arifainchtein/Daffodil/Pin Header 1x4 TH Pitch 2.54mm.stp

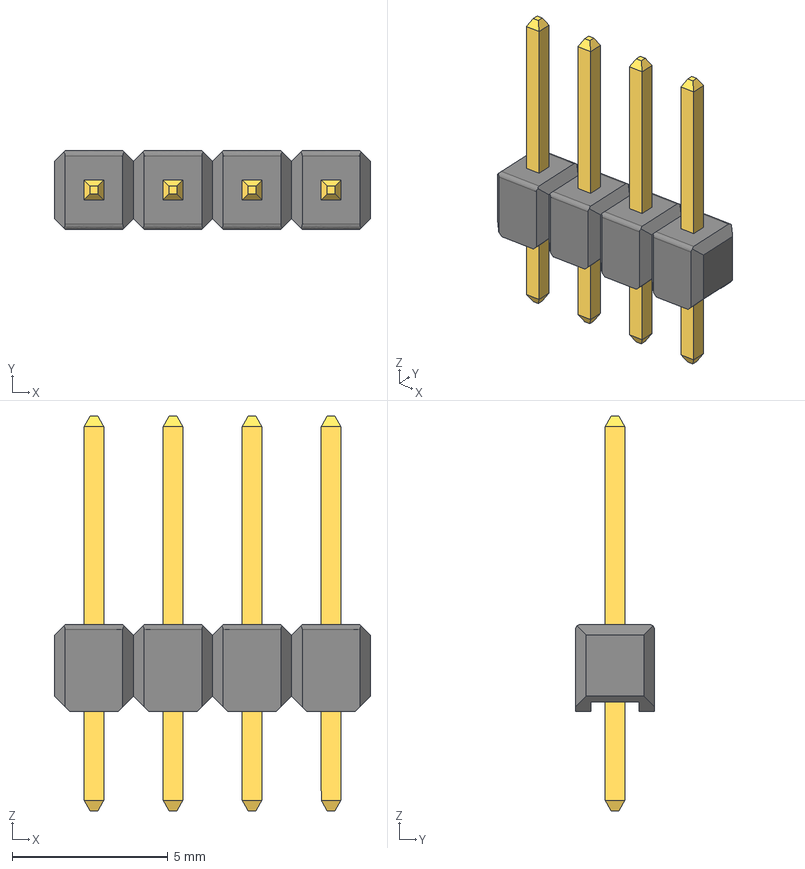
[picture p2: CAD file, 2025-03-26, last stored version]
Pin Header 1x4 TH Pitch 2.54mm.stp
10.2 x 2.54 x 12.7 mm
