arifainchtein/Daffodil/Clipsal 4 Way 20mm enclosure v2.dxf

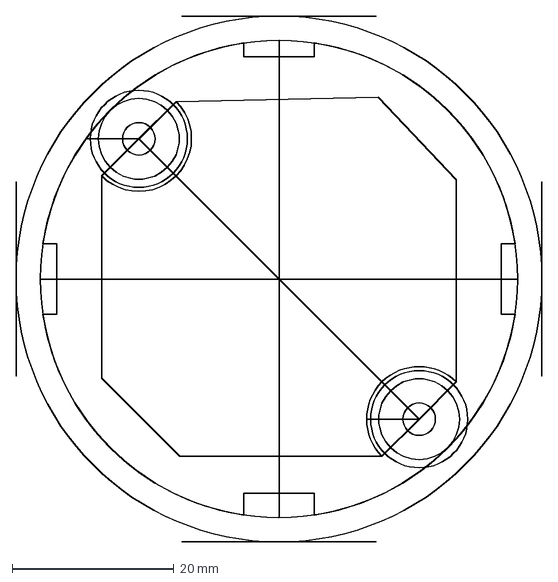
[picture p3: CAD file, 2025-03-26, last stored version]
Clipsal 4 Way 20mm enclosure v2.dxf
65.0 x 65.0 mm
