arifainchtein/Daffodil/PCB For Clipsal 4 Way 20mm enclosure v2.stl

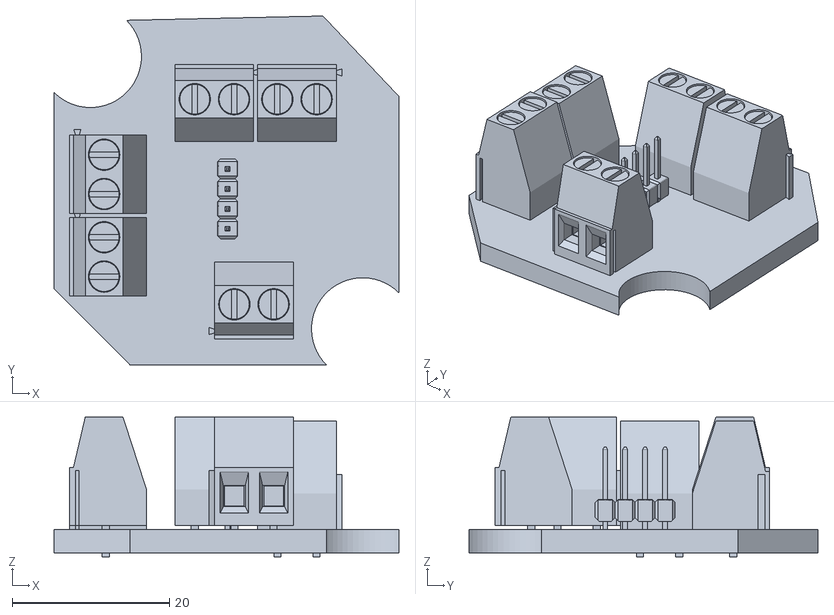
[picture p4: CAD file, 2025-03-26, last stored version]
PCB For Clipsal 4 Way 20mm enclosure v2.stl
43.8 x 44.4 x 17.8
