arifainchtein/Daffodil/PCB Clipsall 4 way.dxf

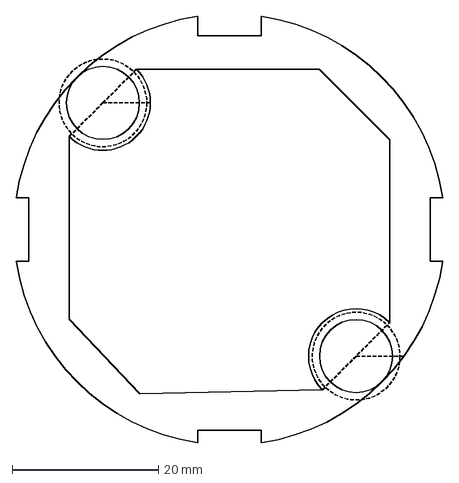
[picture p5: CAD file, 2025-03-26, last stored version]
PCB Clipsall 4 way.dxf
58.4 x 58.4 mm
