arifainchtein/Daffodil/pcb.dxf

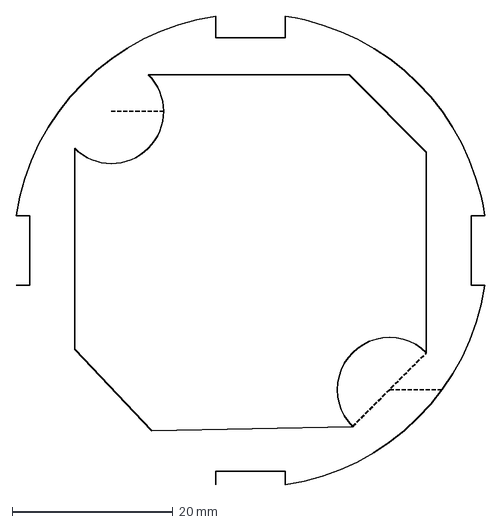
[picture p6: CAD file, 2025-03-26, last stored version]
pcb.dxf
58.4 x 58.4 mm
