arifainchtein/Daffodil/(list of files, cad)

Other CAD files:
Clipsal 4 Way 20mm enclosure v2.f3z
