arifainchtein/Daffodil/Daffodil.ino

/// New Version
#include <PowerManager.h>
#include <DeviceSerial.h>  // the serial number is the efuse MAC (2026-10-30)
#include <SolarInfo.h>
//#include <TimeUtils.h>
#include "Arduino.h"
#include <Timer.h>
#include <PCF8563TimeManager.h>
#include <SPI.h>
#include <LoRa.h>
#include <NewPing.h>  // DAFFODIL_SONAR_TROUGH - echo/trigger ultrasonic on the older boards (2026-11-10)
#include <Esp32SecretManager.h>
#include <FastLED.h>
#include <DaffodilWifiManager.h>
//#include <DaffodilData.h>
#include "OneWire.h"
#include "DallasTemperature.h"
#include <Wire.h>
#include <sha1.h>
#include <totp.h>
#include <SolarPowerData.h>
#include <DigitalStablesData.h>
#include <ChinampaData.h>
#include <LangleyData.h>  // Viewer shows Langley packets
#include "ViewerConfig.h"  // Viewer function (switch 1001)
#include <WeatherForecastManager.h>
#include <DigitalStablesDataSerializer.h>
#include "ADS1X15.h"
#include "SHTSensor.h"

#include <ErrorManager.h>
#include <ErrorDefinitions.h>
#include <DataManager.h>
#include "CommaRecord.h"
#include <LittleFS.h>
#include <Preferences.h>
//#include <driver/adc.h>
#include <BH1750.h>
#include <Adafruit_INA219.h>
#include <VitalSignsTracker.h>
#include <DeviceIdentityTracker.h>
#include <PowerProfileRecord.h>
#include <DeviceCommandRecord.h>
#include <LinkAckRecord.h>
#include <esp_sleep.h>
//#include <driver/adc.h>

#define RTC_CLK_OUT 4
#define MISO 12
#define MOSI 13
#define SCK 14
#define LoRa_SS 15
#define LORA_RESET 16
#define LORA_DI0 17
#define LED_PIN 19
#define LED_CONTROL 23
#define TPL5010_DONE 25
#define SLEEP_SWITCH_26 26
#define TEMPERATURE 27
#define OP_MODE 34
#define SENSOR_INPUT_2 33
#define SENSOR_INPUT_1 18
//#define ADS115_ALERT 35
#define TPL5010_WAKE 35
#define RTC_BATT_VOLT 36



Adafruit_INA219 ina219(0x41);
Adafruit_INA219 solarIna219(0x45);  // Wally USB/panel current sensor — same 50mΩ shunt (LVK12R050CER) as ina219(0x41)
float SHUNT_OHMS = 0.050;    // Shunt resistor value in Ohms — JLCPCB C2596036 50mΩ
#define MAX_CURRENT 1.0      // Maximum expected current in Amps
#define CURRENT_LSB 0.0001   // Current LSB in A/bit — Adafruit default (100µA/bit for 32V/2A mode)
boolean memoryFull = false;
static volatile bool runWatchdog = true;

// Survive deep sleep only. A TPL5010 reset (via EN) or brownout is a power-on reset and clears
// them - which is why the TPL5010 WAKE pulse is a deep-sleep wake source (armDeepSleepWakeSources()).
RTC_DATA_ATTR static uint32_t rtc_intended_wakeup_time = 0; // intended wakeup Unix-seconds
RTC_DATA_ATTR static bool     rtc_comma_mode = false;       // battery critically low; skip full boot
RTC_DATA_ATTR static bool     rtc_has_comma_data = false;   // COMMA session just ended, send recovery LoRa
RTC_DATA_ATTR static uint32_t rtc_comma_first_time = 0;     // Unix-seconds when this COMMA session started
RTC_DATA_ATTR static float    rtc_comma_min_voltage = 99.0f;// lowest voltage seen in this COMMA session
RTC_DATA_ATTR static uint32_t rtc_comma_cycle_count = 0;    // number of 10-min cycles in this session
RTC_DATA_ATTR static char     rtc_device_shortname[8] = {0};// device short name, populated on full boot

// Vital signs (reset / sleep / power / TX telemetry), sent after the data pulse - replaces the
// on-demand DiagnosticRecord (EnableDiagnostics/DisableDiagnostics), retired 2026-10-05.
// See VitalSignsTracker.h and Projects/Annabelle/VitalSigns_Design.pdf.
VitalSignsTracker vitalSigns;
const uint32_t FIRMWARE_BUILD = VitalSignsTracker::buildStamp(__DATE__, __TIME__);
#define VITAL_SIGNS_GAP_MS 1000                         // after the data packet, so Annabelle has read it
// Device identity (product definition + running build), sent after VitalSigns when due - after a
// real reset, after SetProductDefinition, and daily. See DeviceIdentityTracker.h.
DeviceIdentityTracker deviceIdentity;
#define VITAL_SIGNS_AWAKE_INTERVAL_MS (10UL * 60UL * 1000UL)  // only for a unit that stays awake
unsigned long lastVitalSignsMs = 0;
// Copy of the last VitalSignsRecord built, for the web page's Power panel (fillPowerData, 2026-10-14).
// Written in loop(), read by the async_tcp task - lastVitalSignsMux.
VitalSignsRecord lastVitalSigns;
bool haveLastVitalSigns = false;
unsigned long lastVitalSignsBuiltMs = 0;
portMUX_TYPE lastVitalSignsMux = portMUX_INITIALIZER_UNLOCKED;
// COMMA log relay (sendNextCommaRecord): position in the log, consecutive send failures, and a
// stop flag after too many failures this wake. Not RTC - a new wake starts again from record 0.
int commaSendIndex = 0;
uint8_t commaSendFailures = 0;
bool commaSendPaused = false;
#define COMMA_SEND_MAX_FAILURES 5
#define COMMA_SEND_INTERVAL_SEC 2   // seconds between CommaRecord packets, so Annabelle keeps up

String currentSSID;
String ipAddress = "";
boolean initiatedWifi = false;
// #define address 0x40
SHTSensor sht;
bool debug = false;
DataManager dataManager(Serial, LittleFS);

HourlySolarPowerData hourlySolarPowerData;
boolean usingSolarPower = true;

#define NUM_LEDS 15
CRGB leds[NUM_LEDS];

// Maximum trough/tank depth in cm — used to scale measuredHeight into a percentage for the LEDs.
#define MAX_DISTANCE 90

// Waterproof UART ultrasonic (A02YYUW / JSN-SR04T / AJ-SR04M "UART auto" mode). The sensor
// streams a 4-byte frame on its own (every 100-500ms with its RX pin floating/high = processed
// value, the mode we use; ~100ms real-time if RX is pulled low): 0xFF, distance_mm high, distance_mm low,
// checksum = (0xFF + high + low) & 0xFF, at 9600 8N1. RX only — the sensor's own RX pin is left
// unconnected (auto mode needs no trigger). Power it from V50 — the pin 18/33 terminals go
// through the board's 2N7002 level shifters (Q2/Q1), so a 5V TX line is safe.
//
// Pin use per mode (no DigitalStablesData change — slot 2 reuses measuredHeight2):
//   DAFFODIL_WATER_TROUGH        pin18 ultrasonic -> measuredHeight
//   DAFFODIL_WATER_TROUGH_WATER_TEMP pin18 ultrasonic -> measuredHeight, pin33 DS18B20 water temp -> measuredHeight2 (°C)
//   DAFFODIL_2_WATER_TROUGH      pin18 ultrasonic -> measuredHeight, pin33 ultrasonic         -> measuredHeight2 (cm)
//   DAFFODIL_SCEPTIC_TANK        pin18 ultrasonic -> measuredHeight
//   DAFFODIL_WATER_TROUGH_TANK1  pin18 is tank1 pressure, so pin33 ultrasonic -> measuredHeight
//   DAFFODIL_SONAR_TROUGH        echo/trigger ultrasonic, trigger 32 / echo 33 -> measuredHeight (see below)
#define ULTRASONIC_BAUD 9600
#define ULTRASONIC_STALE_MS 5000  // no valid frame for this long -> -99
struct UartUltrasonic {
  HardwareSerial *serial;
  bool started;
  uint8_t frame[4];
  uint8_t frameIndex;
  float lastCm;
  unsigned long lastMillis;
};
UartUltrasonic ultrasonic1 = { &Serial2, false, { 0 }, 0, -99, 0 };  // measuredHeight
UartUltrasonic ultrasonic2 = { &Serial1, false, { 0 }, 0, -99, 0 };  // measuredHeight2 (DAFFODIL_2_WATER_TROUGH)

// DAFFODIL_SONAR_TROUGH (2026-11-10, switch 0101): a trough read by an echo/trigger ultrasonic
// (HC-SR04 / JSN-SR04T in trigger mode) with trigger on 32 and echo on 33 - the wiring of the older
// boards that ran DaffodilBuild14 (Pancho Build 15), e.g. the Chinampa Fish Tank. Same NewPing reading
// that firmware did. Created only in this mode: NewPing's constructor drives its trigger pin, and
// 32/33 have other uses on newer boards. 0 cm = no echo (out of range or no sensor), as DaffodilBuild14
// sent it - Chinampa treats a measuredHeight of 0 as a sensor failure (alert 7) and stops the pump.
#define SONAR_TRIGGER_PIN 32
#define SONAR_ECHO_PIN 33
#define SONAR_MAX_DISTANCE_CM 200
#define SONAR_PINGS 5             // median of 5 (~150 ms)
NewPing *sonar = nullptr;

// TX-summary sampler. Must stay below the struct definitions: the IDE inserts its auto-prototypes
// just above the first function in the sketch, so defining one earlier hides UartUltrasonic from them.
// Called on core 0 while sendMessage() blocks in LoRa.endPacket(false).
// INA219 current is + while the battery discharges (batteryCurrent < 0 means charging).
bool daffodilTxSample(int16_t &batteryDraw_mA, uint16_t &battery_mV) {
  batteryDraw_mA = (int16_t)(ina219.getShuntVoltage_mV() / SHUNT_OHMS);  // getCurrent_mA() reads half on 50 mOhm
  battery_mV = (uint16_t)(ina219.getBusVoltage_V() * 1000.0f);
  return true;
}

// The battery ledger (VitalSignsTracker::startLedger) reads both INA219s from core 0 every ~70 ms
// while the main code on core 1 also reads them. An INA219 read is a register-pointer write then a
// read, so the two can get each other's register - every INA219 access holds this lock (recursive,
// so nested helpers are fine). Created first thing in setup().
// Since 2026-10-13 it guards EVERY I2C read on core 1, not just the INA219s: Wire has one receive
// buffer, so a ledger read between another device's requestFrom() and its Wire.read()s replaces
// those bytes (an RTC read gave 2030-2032 dates with the right time of day). The RTC is read once
// per clock tick (loop) under this lock; everything else uses currentTimerRecord.
SemaphoreHandle_t inaMutex = nullptr;
struct InaLock {
  InaLock() { if (inaMutex) xSemaphoreTakeRecursive(inaMutex, portMAX_DELAY); }
  ~InaLock() { if (inaMutex) xSemaphoreGiveRecursive(inaMutex); }
};

extern bool foundINA219;       // defined with the other sensor flags further down
extern bool foundINA219Solar;

// Ledger callback (core 0): battery and panel read back to back under the lock.
bool daffodilLedgerSample(LedgerSample &s) {
  if (!foundINA219) return false;
  InaLock lock;
  float batShunt_mV = ina219.getShuntVoltage_mV();
  float batBus_V = ina219.getBusVoltage_V();
  s.battery_uA = (int32_t)(batShunt_mV / SHUNT_OHMS * 1000.0f);
  s.battery_mV = batBus_V > 0 ? (uint16_t)(batBus_V * 1000.0f) : 0;
  if (foundINA219Solar) {
    float panShunt_mV = solarIna219.getShuntVoltage_mV();
    float panBus_V = solarIna219.getBusVoltage_V();
    s.panel_uA = (int32_t)(panShunt_mV / SHUNT_OHMS * 1000.0f);
    s.panel_mV = panBus_V > 0 ? (uint16_t)(panBus_V * 1000.0f) : 0;
  } else {
    s.panel_uA = 0;
    s.panel_mV = 0;
  }
  return true;
}

// Ledger mode callback: single-sample battery conversions during a LoRa TX (true peak), back to
// 128-sample averaging after. Only the shunt ADC bits (6:3) change.
void daffodilLedgerMode(bool fastMode) {
  InaLock lock;
  Wire.beginTransmission(0x41);
  Wire.write(0x00);
  if (Wire.endTransmission() != 0) return;
  if (Wire.requestFrom((uint8_t)0x41, (uint8_t)2) < 2) return;
  uint16_t cfg = ((uint16_t)Wire.read() << 8) | (uint8_t)Wire.read();
  cfg = (cfg & ~0x0078) | (fastMode ? INA219_CONFIG_SADCRES_12BIT_1S_532US : INA219_CONFIG_SADCRES_12BIT_128S_69MS);
  Wire.beginTransmission(0x41);
  Wire.write(0x00);
  Wire.write((cfg >> 8) & 0xFF);
  Wire.write(cfg & 0xFF);
  Wire.endTransmission();
}

// Waterproof DS18B20 water temperature on pin 33 (DAFFODIL_WATER_TROUGH_WATER_TEMP only), its own OneWire
// bus separate from the board DS18B20 on pin 27. No external pull-up needed: the pin-33 terminal
// already goes through the board's 2N7002 level shifter (Q1, R5 4.7k to V33 on the GPIO side,
// R7 10k to V50 on the terminal side), so the probe runs off V50 and the 10k is the bus pull-up.
OneWire waterOneWire(SENSOR_INPUT_2);
DallasTemperature waterTempSensor(&waterOneWire);
bool waterTempStarted = false;

#define OPERATING_STATUS_SLEEP 1
#define OPERATING_STATUS_NO_LED 2
#define OPERATING_STATUS_FULL_MODE 3
#define OPERATING_STATUS_CLOUDY 4
#define OPERATING_STATUS_COMMA 5   // battery critically low — permanent deep sleep


ErrorManager errorManager;



// LoRa parameters, registers and constants



#define REG_OP_MODE 0x01
#define REG_IRQ_FLAGS 0x12
#define REG_RSSI_VALUE 0x1B
#define MODE_CAD 0x87
#define IRQ_CAD_DONE_MASK 0x04
#define IRQ_CAD_DETECTED_MASK 0x02

#define CAD_TIMEOUT 5000    // CAD timeout in milliseconds
#define MAX_RETRIES 5       // Maximum transmission retries
#define MIN_BACKOFF 500     // Minimum backoff time in milliseconds
#define MAX_BACKOFF 1500    // Maximum backoff time in milliseconds
#define RSSI_THRESHOLD -80  // RSSI threshold in dBm





//define LORA_SAMPLES 3 // Number of samples to take
//define CHECK_LORA_DELAY 2 // Delay between samples in ms

//CHT8305 CHT(0x44);
bool loraTxOk = false;


//TaskHandle_t watchdogTask;
//i2c addresses:
// 40=DFRobot i2c temperature sensor
// 48= ADS1115
// 51= PCF8563T
// 23= bh1750

BH1750 lightMeter;

ADS1115 ADS(0x48);
volatile bool RDY = false;

OneWire oneWire(TEMPERATURE);
DallasTemperature tempSensor(&oneWire);

Timer viewTimer(3);
Timer remoteMonitorTimer(5);
#define MAXIMUM_STORED_RECORDS 2000

// bool internetAvailable;
bool wifiActiveSwitch;
#define uS_TO_S_FACTOR 60000000 /* Conversion factor for micro seconds to minutes */

Timer dsUploadTimer(60);
static volatile int flowMeterPulseCount;
static volatile int flowMeterPulseCount2;
static unsigned long flowMeterPreviousMillis = 0;
static unsigned long flowMeterPreviousMillis2 = 0;

volatile bool loraReceived = false;
volatile int loraPacketSize = 0;
volatile bool loraDio0Fired = false;  // set by onLoraDio0(), handled at the top of loop()


uint8_t displayStatus = 0;
uint8_t loraLastResult = -99;
LoRaError cadResult;
float avgRssi = 0;

#define SHOW_TEMPERATURE 0
#define SHOW_SCEPTIC 1
#define SHOW_INTERNET_STATUS 2
#define SEND_LORA_STATUS 3
#define SHOW_ERROR_STATUS 5
#define SHOW_BATTERY_STATUS 4
//
// sleeping parameters
//
// LiFePO4 battery thresholds (Build 7: replaced supercapacitors with 3.2V LiFePO4 cell)
#define BATTERY_CAPACITY_MAH 600.0   // usable capacity of LiFePO4 123A cell
// PowerProfileRecord - this product's battery/sensor hardware facts for the Cerebellum's SOC
// (a battery or panel change means editing these and reflashing). 0 = "use the default".
#define PP_CHEMISTRY            BATTERY_CHEMISTRY_LIFEPO4
#define PP_CELLS_IN_SERIES      1
#define PP_CAPACITY_MAH         600
#define PP_CHARGE_EFFICIENCY    0         // Cerebellum default for LiFePO4
#define PP_REST_FULL_MV         0
#define PP_REST_EMPTY_MV        0
#define PP_ABSORPTION_MV        3600      // MCP73123-22 regulation voltage
#define PP_CUTOFF_MV            2800      // = commaVoltage
#define PP_BATTERY_TEMP_SOURCE  BATTERY_TEMP_SOURCE_NONE
#define PP_BATTERY_LSB_UA       200       // 50 mOhm shunt, 10 uV INA219 shunt LSB
#define PP_PANEL_LSB_UA         200
#define PP_SLEEP_UA             0         // not bench-measured yet
#define PP_UNMEASURED_BASELINE_UA 0
#define NIGHT_MAX_SLEEP_SEC 300      // longest sleep while the cell is healthy: a packet every 5 min all night (timer wakes before the ~10 min TPL5010 pulse)
#define NIGHT_CAP_MIN_VOLTAGE 3.15   // battery (under wake load) at or above this gets the 15 min cap

// WiFi on demand (2026-10-14). The automatic start needs the battery above 3.35 V for 30 s, which
// a Daffodil only reaches while charging hard around midday - so its web page (settings, vital
// signs) was out of reach most of the day. A DeviceCommandRecord from Annabelle's web page or
// Paula turns WiFi on for a while regardless (and keeps the unit awake for it), or off. See
// acceptDeviceCommand() and listenForReplies().
#define WIFI_ON_DEMAND_DEFAULT_MIN 15
#define WIFI_ON_DEMAND_MAX_MIN 60
#define WIFI_ON_DEMAND_FLOOR_V 3.20f    // below this (under load) on-demand WiFi ends and the unit may sleep
#define WIFI_OFF_SUPPRESS_AUTO_SEC 3600 // after an explicit "off", the automatic midday start waits this long
#define COMMAND_LISTEN_MS 700           // listen after each VitalSigns: sender's 100 ms + CAD + ~0.19 s on air + margin
// 1 = listen after every VitalSigns, day and night (~1.5-2 mAh a night at 5 min wakes, whether
// or not a command ever comes). 0 = daylight only: no night cost, a night command waits for sunrise.
#define LISTEN_FOR_COMMANDS_AT_NIGHT 1
#define DEVICE_COMMAND_MAX_CLOCK_DIFF_SEC 900
RTC_DATA_ATTR uint32_t wifiOnDemandUntil = 0;        // code-time seconds (getTimeForCodeGeneration), 0 = off
RTC_DATA_ATTR uint32_t wifiAutoSuppressedUntil = 0;  // code-time seconds, see WIFI_OFF_SUPPRESS_AUTO_SEC
bool wifiOnDemandWasOn = false;  // loop(): on-demand WiFi was running last pass - notices its end
bool wifiOffRequested = false;   // set by acceptDeviceCommand(), acted on in loop()
float sleepingVoltage = 3.12;         // Force deep sleep — cliff edge for LiFePO4 123A
float commaVoltage    = 2.80;         // COMMA threshold — below this, skip all work and wait for solar recovery
float commaExitVoltage = 3.12;        // COMMA only ends once the resting battery reaches this (= sleepingVoltage).
                                      // Exiting at commaVoltage itself looped forever on a weak cell: it rests
                                      // just above 2.80V, boots, WiFi load sags it below, COMMA again (2026-11-06).
                                      // A charging LiFePO4 sits well above this, so charging also ends COMMA.

uint8_t numberSecondsWithMinimumWifiVoltageForStartWifi = 30;
uint8_t currentSecondsWithWifiVoltage = 0;
float minimumInitWifiVoltage = 3.35;  // Battery must sustain this for 30 s before WiFi starts
//uint8_t sleepingTime = 1;
float minimumLEDVoltage = 3.18;       // Turn off LEDs below this — warning before sleep at 3.15V
float minimumVoltageForSleepLedAlert = 3.10;  // goToSleep() only flashes the 1 s battery indicator at or above this. Below it the ~150 mA LED load browned the board out on a low cell (TopTank 2026-10-07: ~46 brownout resets from 2.80 V to 1.2 V) — the sleep LoRa message is still sent.
uint8_t dimLedBrightness = 20;        // Minimum brightness when LoRa TX budget is too low for full power
uint8_t nightLedBrightness = 30;      // Minimum LED brightness (night / zero efficiency)
float luxNightThreshold = 30.0;       // Lux below this is considered actual darkness → cap at nightLedBrightness
float currentLux = -99;               // Local only, not transmitted — removed from DigitalStablesData 2026-09-01 to fund measuredHeight2/maximumScepticHeight2. Still read locally from BH1750 for LED darkness detection, same as always.
float ledCurrentPerLedAmps = 0.020;   // Same per-LED current budget PowerManager uses (currentPerLed in setup()) — kept as its own constant here so calculatePowerAwareLedBrightness() doesn't need setup()'s local copy.
float v50iCloudyThreshold = 3.5;     // V50_I below this during solar hours means the panel isn't harvesting enough — cloudy. Lowered 2026-07-24: field data (TopTank, clear midday sun, actively charging) showed V50_I sitting at 4.09-4.47V — the old 4.5V threshold was false-triggering CLOUDY on every wake. Still wants validation against real overcast-day readings.
float panelCurrentCloudyThreshold_mA = 30.0;  // Doubled 2026-10-10 when panelCurrent switched from getCurrent_mA() (half scale on the 50mOhm shunt) to shunt mV / SHUNT_OHMS - same real threshold as the old 15. Wally 0x45 panelCurrent below this during solar hours means cloudy. Lowered 2026-07-24: field data (TopTank, clear midday sun) showed panelCurrent as low as 22-80mA during normal charging — the old 60mA threshold was false-triggering CLOUDY. Still wants validation against real overcast-day readings.
float minimumWifiVoltage = 3.28;      // Turn off WiFi first to preserve power for LoRa
// Solar switch OFF (2026-11-06): a charged LiFePO4 rests at ~3.30V and sags under the AP's load, so
// 3.35 start / 3.28 cut-off meant WiFi rarely started and dropped the moment a phone connected
// (HorseTrough). Same 0.1V start/stop gap, set below the cell's working plateau, above sleepingVoltage.
float minimumInitWifiVoltageNoSolar = 3.25;
float minimumWifiVoltageNoSolar = 3.15;
float wifiStartVoltage() { return usingSolarPower ? minimumInitWifiVoltage : minimumInitWifiVoltageNoSolar; }
float wifiCutVoltage() { return usingSolarPower ? minimumWifiVoltage : minimumWifiVoltageNoSolar; }
uint8_t secondsSinceLastDataSampling = 0;
uint16_t secondsSinceLastWeatherData = 9999; // 9999 = never received
// RTC time the last forecast was accepted, so "weather fresh" (opMode bit1, LED 14, the cloudy
// forecast check) survives deep sleep: secondsSinceLastWeatherData is plain RAM and restarted at
// 9999 on every wake, so a sleeping unit reported "not fresh" right after accepting a forecast
// (TopTank 2026-10-12). Lost on a real reset like every RTC_DATA_ATTR - then "never" is correct.
RTC_DATA_ATTR uint32_t rtc_lastWeatherEpoch = 0;
// RTC time the last 8-slot forecast (WeatherForecast8Update) was accepted: Annabelle follows it with
// the old 4-slot packet, which is then ignored instead of being taken as a replay. 0 = never.
RTC_DATA_ATTR uint32_t rtc_lastWeather8Epoch = 0;
#define WEATHER8_PREFERRED_SEC 600
// How strongly the last accepted forecast was heard - this unit's link to Annabelle, reported in the
// answer to Paula's ping (LinkAckRecord.gatewayRssi), so Paula's map can show which device could
// relay a spot Annabelle can't hear. 0 = none since the last real reset.
RTC_DATA_ATTR int16_t rtc_weatherRssi = 0;
RTC_DATA_ATTR int8_t rtc_weatherSnrQ = 0;
uint8_t cloudyDutyCyclePercent = 50;         // % of display cycles with LEDs on in CLOUDY mode
uint8_t cloudyThreshold = 70;               // forecast cloudiness % to enter CLOUDY mode
bool cloudyLedCycleOn = true;               // toggles each full display cycle in CLOUDY mode
uint8_t delayTime = 10;
#define UNIQUE_ID_SIZE 8
bool loraActive = false;
DigitalStablesConfigData digitalStablesConfigData;
DigitalStablesData digitalStablesData;
DaffodilCommandData daffodilCommandData;

//
// csw variables
//

float rawCSWValue;
float factor = 1;
int16_t cswOutput;
// Captured at the very top of setup(), before anything else runs, so a future NVS-content
// mystery (device name/calibration blanked between boots) can be cross-checked against what
// kind of reset actually preceded it - POWERON/EXT vs BROWNOUT vs a software/upload reset -
// instead of relying on what the operator remembers doing. esp_reset_reason() is unrelated to
// esp_sleep_get_wakeup_cause() (deep-sleep wake reason, printed separately by
// print_wakeup_reason()) - this covers the boot itself, sleep or not.
esp_reset_reason_t lastResetReason;
const char* resetReasonToString(esp_reset_reason_t r) {
  switch (r) {
    case ESP_RST_POWERON:   return "POWERON (cold power-on)";
    case ESP_RST_EXT:       return "EXT (external reset pin)";
    case ESP_RST_SW:        return "SW (software reset, e.g. esptool/upload)";
    case ESP_RST_PANIC:     return "PANIC (crash)";
    case ESP_RST_INT_WDT:   return "INT_WDT (interrupt watchdog)";
    case ESP_RST_TASK_WDT:  return "TASK_WDT (task watchdog)";
    case ESP_RST_WDT:       return "WDT (other watchdog)";
    case ESP_RST_DEEPSLEEP: return "DEEPSLEEP (woke from deep sleep)";
    case ESP_RST_BROWNOUT:  return "BROWNOUT (voltage dropped too low)";
    case ESP_RST_SDIO:      return "SDIO";
    default:                return "UNKNOWN";
  }
}
bool noBatteryDetected = false;  // set once in setup(); which CSW threshold table got used
// Gates battery-over-discharge protection (COMMA mode, low-voltage sleep/LED/WiFi cutoffs) —
// deliberately independent of usingSolarPower. usingSolarPower/bit5 controls the sensor-reading-
// frequency-vs-battery-duration tradeoff (solar-efficiency-driven sleep scheduling); a unit set
// to sample more frequently (bit5=0) still has a real battery to protect if one is attached, so
// that protection must not depend on the solar bit. Set once in setup() from noBatteryDetected.
bool hasBattery = true;

PCF8563TimeManager timeManager(Serial);
GeneralFunctions generalFunctions;
Esp32SecretManager secretManager(timeManager);
SolarInfo *solarInfo;
PowerManager *powerManager;
WeatherForecastManager *weatherForecastManager;
double lightMeterCorrectingFactor = 3.45;
// The web app (data/ folder) lives in its own read-only "www" partition, flashed with each firmware
// release, so an update never touches LittleFS (sensor data) or NVS (Preferences). Mounted in setup().
fs::LittleFSFS wwwFS;
DaffodilWifiManager wifiManager(Serial, wwwFS, timeManager, secretManager, digitalStablesData, digitalStablesConfigData);

//int badPacketCount = 0;
byte msgCount = 0;         // count of outgoing messages
byte localAddress = 0xFF;  // address of this device
byte destination = 0xAA;   // destination to send to

long lastPulseTime = 0;
uint8_t uniqueId[UNIQUE_ID_SIZE];
long lastMillis;
uint8_t SECONDOFFSET = 10;
uint8_t timeZoneHours = 10;
static byte monthDays[] = { 31, 28, 31, 30, 31, 30, 31, 31, 30, 31, 30, 31 };
String currentIpAddress = "No IP";
bool inPulse = true;

long lastTimeUpdateMillis = 0;
RTCInfoRecord currentTimerRecord;
#define TIME_RECORD_REFRESH_SECONDS 3

volatile bool clockTicked = false;
volatile bool lowVoltageAlert = false;

portMUX_TYPE mux = portMUX_INITIALIZER_UNLOCKED;
RTCInfoRecord lastReceptionRTCInfoRecord;

const int SHARED_SECRET_LENGTH = 27;
char secretCode[SHARED_SECRET_LENGTH];
bool opmode = false;



bool foundlcd = false;
bool foundtemp = false;
bool foundADS = false;
bool foundBH1750 = false;
bool foundINA219 = false;
bool foundINA219Solar = false;  // Wally 0x45 panel/USB current sensor — optional, may be absent on unverified/older Wally boards
bool PCF8563T = false;
bool foundDS18B20 = false;

//
// watchdog
//
TaskHandle_t refreshTaskHandle = NULL;
volatile bool wakeSignalReceived = false;
unsigned long lastWakeTime = 0;
const unsigned long WAKE_INTERVAL_MS = 1000;  // Expected wake interval


String serialNumber;
struct TempHum {
  float temp = -99;
  float hum = -99;

} tempHum;

const float R1 = 1000000.0;  // Resistance of R1 in ohms (1 MΩ)
const float R2 = 2000000.0;  // Resistance of R2 in ohms (2 MΩ)
const float Vref = 3.3;      // Reference voltage of the ESP32

int view_milliseconds = 5000;
long lastswitchmillis = 0;
boolean showTemperature = false;
// Alternates the sensor-value LED display between slot 1 (pin 18) and slot 2 (pin 33) on
// two-slot modes (FUN_2_FLOW, FUN_2_TANK, FUN_1_FLOW_1_TANK, DAFFODIL_WATER_TROUGH_TANK1) —
// same toggle-per-cycle pattern as showTemperature.
boolean showSensorSlot2 = false;
uint8_t color = 0;
String timezone;

const char *display1URL = "http://Ra.local/TeleonomeServlet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";
void beginUltrasonic(UartUltrasonic &u, int rxPin) {
  if (u.started) return;
  // Bigger RX buffer (~25s of frames) so a long blocking stretch (WiFi upload etc.) between
  // readSensorData() calls doesn't overflow it. Must be set before begin().
  u.serial->setRxBufferSize(1024);
  u.serial->begin(ULTRASONIC_BAUD, SERIAL_8N1, rxPin, -1);
  u.started = true;
}

// Non-blocking: parses whatever frames arrived since the last call and returns the newest valid
// distance in cm, or -99 if the UART isn't running or no valid frame for ULTRASONIC_STALE_MS.
// DAFFODIL_SONAR_TROUGH's reading - see SONAR_TRIGGER_PIN. -99 when the mode isn't on.
float readSonarCm() {
  if (!sonar) return -99;
  unsigned long us = sonar->ping_median(SONAR_PINGS);
  if (us == 0) return 0;  // no echo
  return us / (float)US_ROUNDTRIP_CM;
}

float readUltrasonicCm(UartUltrasonic &u) {
  if (!u.started) return -99;
  while (u.serial->available()) {
    uint8_t b = u.serial->read();
    if (u.frameIndex == 0 && b != 0xFF) continue;  // hunt for the header
    u.frame[u.frameIndex++] = b;
    if (u.frameIndex < 4) continue;
    uint8_t sum = (u.frame[0] + u.frame[1] + u.frame[2]) & 0xFF;
    if (sum == u.frame[3]) {
      uint16_t mm = ((uint16_t)u.frame[1] << 8) | u.frame[2];
      u.lastCm = mm / 10.0;
      u.lastMillis = millis();
      u.frameIndex = 0;
    } else {
      // Bad checksum — probably synced on a data byte that happened to be 0xFF. Resync on the
      // next 0xFF inside this frame, if any, instead of throwing all 4 bytes away.
      uint8_t keep = 0;
      for (uint8_t i = 1; i < 4; i++) {
        if (u.frame[i] == 0xFF) {
          keep = 4 - i;
          memmove(u.frame, u.frame + i, keep);
          break;
        }
      }
      u.frameIndex = keep;
    }
  }
  if (u.lastMillis == 0 || millis() - u.lastMillis > ULTRASONIC_STALE_MS) return -99;
  return u.lastCm;
}

void beginWaterTemperature() {
  waterTempSensor.begin();
  waterTempSensor.setResolution(10);  // 0.25°C, ~190ms conversion
  // One blocking conversion at boot so the first read isn't the DS18B20's 85°C power-on value.
  waterTempSensor.setWaitForConversion(true);
  waterTempSensor.requestTemperatures();
  waterTempSensor.setWaitForConversion(false);
  waterTempStarted = true;
}

// Non-blocking: returns the conversion started on the previous call, then starts the next one.
// -99 if the sensor is missing/disconnected.
float readWaterTemperature() {
  if (!waterTempStarted) return -99;
  float t = waterTempSensor.getTempCByIndex(0);
  waterTempSensor.requestTemperatures();
  if (t == DEVICE_DISCONNECTED) return -99;  // -127; the legacy Dallas lib in the sketchbook has no DEVICE_DISCONNECTED_C
  return t;
}

void IRAM_ATTR pulseCounter() {
  flowMeterPulseCount++;
}

void IRAM_ATTR pulseCounter2() {
  flowMeterPulseCount2++;
}

void IRAM_ATTR clockTick() {
  portENTER_CRITICAL_ISR(&mux);
  clockTicked = true;
  portEXIT_CRITICAL_ISR(&mux);
}


//
// Lora Functions
//

template<typename T>
uint8_t calculateChecksum(const T &data) {
  uint8_t checksum = 0;
  const uint8_t *dataPtr = (const uint8_t *)&data;

  size_t checksumOffset = 0;
  if constexpr (std::is_same<T, DigitalStablesData>::value) {
    checksumOffset = offsetof(DigitalStablesData, checksum);
  } else if constexpr (std::is_same<T, RequestCommand>::value) {
    checksumOffset = offsetof(RequestCommand, checksum);
  } else if constexpr (std::is_same<T, VitalSignsRecord>::value) {
    checksumOffset = offsetof(VitalSignsRecord, checksum);
  } else if constexpr (std::is_same<T, CommaRecord>::value) {
    checksumOffset = offsetof(CommaRecord, checksum);
  } else if constexpr (std::is_same<T, DeviceIdentityRecord>::value) {
    checksumOffset = offsetof(DeviceIdentityRecord, checksum);
  } else if constexpr (std::is_same<T, PowerProfileRecord>::value) {
    checksumOffset = offsetof(PowerProfileRecord, checksum);
  }

  for (size_t i = 0; i < checksumOffset; i++) {
    checksum ^= dataPtr[i];
  }
  for (size_t i = checksumOffset + sizeof(uint8_t); i < sizeof(T); i++) {
    checksum ^= dataPtr[i];
  }
  return checksum;
}



template<typename T>
int sendMessage(const T &inputData, bool skipCAD = false) {
  T dataToSend = inputData;

  readSensorData();

  long code = secretManager.generateCode(timeManager.getTimeForCodeGeneration(currentTimerRecord));

  if constexpr (std::is_same<T, DigitalStablesData>::value || std::is_same<T, RequestCommand>::value || std::is_same<T, VitalSignsRecord>::value || std::is_same<T, CommaRecord>::value || std::is_same<T, DeviceIdentityRecord>::value || std::is_same<T, PowerProfileRecord>::value) {
    dataToSend.totpcode = code;
    dataToSend.checksum = 0;
    dataToSend.checksum = calculateChecksum(dataToSend);
  }

  if (debug) {
    Serial.print("Sending LoRa SN=");
    Serial.print(serialNumber);
    Serial.print(" TOTP=");
    Serial.print(code);
    Serial.print(" Checksum=");
    Serial.println(dataToSend.checksum, HEX);
  }

  LoRa_txMode();

  uint8_t result = 99;
  int retries = 0;
  bool keepGoing = true;
  bool failCounted = false;  // endTx() already counted a failed key-up
  long startsendingtime = millis();
  LoRa.idle();
  LoRa.flush();
  delay(50);
  while (keepGoing) {
    cadResult = skipCAD ? LORA_OK : performCAD();

    if (cadResult == LORA_OK) {
      bool ledsWereOn = digitalRead(LED_CONTROL);
      if (ledsWereOn) digitalWrite(LED_CONTROL, LOW);  // kill LEDs during TX to reduce V50 sag
      int beginPacketResult = LoRa.beginPacket();
      // beginPacketResult==0 means LoRa.isTransmitting() already read true at this point —
      // beginPacket() then skips resetting the FIFO pointer/length entirely, so the write()
      // below lands on stale FIFO state. Never checked before; pollIterations has been
      // reading 0 (radio never actually shows MODE_TX) every time this session so far.
      if (debug) {
        Serial.print("beginPacketResult=");
        Serial.println(beginPacketResult);
      }
      LoRa.write((uint8_t *)&dataToSend, sizeof(T));
      long start = millis();
      // TX summary for the vital signs (battery draw before/peak/after, panel current, V50_I,
      // sag, duration). Not for the VitalSigns packet itself, so each record reports the DATA
      // packet's transmit. The old TX_CURRENT path polled LoRa.isTransmitting(), which never
      // read busy on this hardware (pollIterations==0) - the tracker samples from a core-0 task
      // while endPacket(false) blocks on the real TX-done flag instead.
      constexpr bool trackTx = !std::is_same<T, VitalSignsRecord>::value && !std::is_same<T, CommaRecord>::value && !std::is_same<T, DeviceIdentityRecord>::value && !std::is_same<T, PowerProfileRecord>::value;
      if (trackTx) {
        int16_t txPanel_mA = -1;
        if (foundINA219Solar) {
          InaLock lock;
          txPanel_mA = (int16_t)(solarIna219.getShuntVoltage_mV() / SHUNT_OHMS);
        }
        vitalSigns.beginTx(foundINA219 ? daffodilTxSample : nullptr,
                           txPanel_mA,
                           foundADS && digitalStablesData.v50Voltage > 0 ? (uint16_t)(digitalStablesData.v50Voltage * 1000) : 0);
      }
      bool txOk = LoRa.endPacket(false);
      if (trackTx) {
        vitalSigns.endTx(txOk);
        failCounted = true;
      }
      result = txOk ? LORA_OK : LORA_TX_FAILED;
      if (ledsWereOn) digitalWrite(LED_CONTROL, HIGH);  // restore LEDs after TX
      delay(50);
      if (debug) {
        Serial.print("Handover took=");
        Serial.print(millis() - start);
        Serial.print("TX took ");
        Serial.print(millis() - startsendingtime);
        Serial.println("ms");
      }
      keepGoing = false;
    } else if (cadResult == LORA_CHANNEL_BUSY) {
      int backoff = random(MIN_BACKOFF * (1 << retries), MAX_BACKOFF * (1 << retries));
      if (debug) Serial.println("Busy, waiting " + String(backoff) + "ms");
      delay(backoff);
      retries++;
      keepGoing = (retries < MAX_RETRIES);
      if (!keepGoing) result = LORA_MAX_RETRIES_REACHED;
    } else {
      result = cadResult;
      keepGoing = false;
    }
  }

  // Sends that never went out (busy channel through every back-off, CAD error) and failed key-ups
  // of the packets endTx() doesn't follow (VitalSigns, ...) count as TX failures too - so a
  // VitalSigns seq gap with no matching loraTxFailCount rise is a packet Annabelle missed.
  if (result != LORA_OK && !failCounted) vitalSigns.noteTxFailed();
  delay(50);
  msgCount++;
  LoRa_rxMode();
  return result;
}

// DIO0 interrupt: only set a flag. arduino-LoRa's own LoRa.onReceive() handler reads the radio
// over SPI inside the interrupt, and SPI on ESP32 core 3.x takes a mutex, which must never be
// waited on in an ISR (Annabelle's xQueueSemaphoreTake assert PANIC, 2026-10-05). The packet is
// read in loop() with LoRa.parsePacket().
void IRAM_ATTR onLoraDio0() {
  loraDio0Fired = true;
}

// Received packet, copied out of the radio the moment DIO0 is seen so the radio can go straight
// back to listening (2026-10-12). Before, parsePacket() left the radio idle until the next 1 s
// clockTicked pass processed the packet - and that pass can also run delay(random(100,3000)) and a
// ~1.3 s transmit - so every packet heard (FISH sends one every few seconds) left this unit deaf
// for seconds, and it missed most of Annabelle's weather/time broadcasts (TopTank, while a bench
// unit with the same firmware caught them). processLora() reads from here instead of the radio.
uint8_t loraRxBuf[256];
int loraRxLen = 0;
int loraRxPos = 0;
int loraRxRssi = 0;
float loraRxSnr = 0;
uint32_t loraRxAtMs = 0;  // when it was copied out - Paula's ping answer slot counts from here (packets are handled on the 1 s tick)

size_t loraRxRead(uint8_t *dst, size_t len) {
  size_t n = 0;
  while (n < len && loraRxPos < loraRxLen) dst[n++] = loraRxBuf[loraRxPos++];
  while (n < len) dst[n++] = 0;
  return len;
}

int loraRxByte() {
  return loraRxPos < loraRxLen ? loraRxBuf[loraRxPos++] : -1;
}
// =====================================================================================
// Viewer (DAFFODIL_VIEWER, switch 1001) - see ViewerConfig.h for the config format.
// =====================================================================================
#define VIEWER_LISTEN_MS 25000  // solar pulse wake: Chinampa transmits about every 20 s

// processLora() tells packets apart by size, so each viewer type needs a size nothing else uses.
static_assert(sizeof(ChinampaData) != sizeof(DigitalStablesData) && sizeof(ChinampaData) != sizeof(RequestCommand)
                && sizeof(ChinampaData) != sizeof(DeviceCommandRecord) && sizeof(ChinampaData) != sizeof(WeatherForecastUpdate),
              "ChinampaData needs a size no other LoRa packet uses - processLora() tells packets apart by size");
static_assert(sizeof(LangleyData) != sizeof(DigitalStablesData) && sizeof(LangleyData) != sizeof(ChinampaData)
                && sizeof(LangleyData) != sizeof(RequestCommand) && sizeof(LangleyData) != sizeof(DeviceCommandRecord)
                && sizeof(LangleyData) != sizeof(WeatherForecastUpdate),
              "LangleyData needs a size no other LoRa packet uses - processLora() tells packets apart by size");
static_assert(sizeof(ChinampaData) <= 255 && sizeof(LangleyData) <= 255, "over the LoRa payload limit");
static_assert(sizeof(WeatherForecast8Update) != sizeof(DigitalStablesData) && sizeof(WeatherForecast8Update) != sizeof(ChinampaData)
                && sizeof(WeatherForecast8Update) != sizeof(LangleyData) && sizeof(WeatherForecast8Update) != sizeof(RequestCommand)
                && sizeof(WeatherForecast8Update) != sizeof(DeviceCommandRecord) && sizeof(WeatherForecast8Update) != sizeof(WeatherForecastUpdate),
              "WeatherForecast8Update needs a size no other LoRa packet uses");

constexpr size_t viewerMax(size_t a, size_t b) {
  return a > b ? a : b;
}
#define VIEWER_RAW_MAX viewerMax(sizeof(ChinampaData), viewerMax(sizeof(DigitalStablesData), sizeof(LangleyData)))

ViewerConfig viewerCfg;
ViewerConfig viewerPendingCfg;          // set by the web/serial handler, applied by loop()
volatile bool viewerCfgPending = false;
uint8_t viewerPageIndex = 0;

// Every device the viewer has heard: its last packet, as raw bytes (a struct with member
// initializers would make the startup code wipe it every boot). In RTC memory so a solar viewer
// keeps it across deep sleep. at = codeTimeNow() when heard, 0 = empty entry.
struct ViewerHeard {
  long at;
  int16_t rssi;
  uint8_t type;
  char name[VIEWER_NAME_LEN];
  uint8_t raw[VIEWER_RAW_MAX];
};
RTC_DATA_ATTR ViewerHeard viewerHeard[VIEWER_MAX_DEVICES];
// The web page (async_tcp task) reads the table while loop() writes it.
portMUX_TYPE viewerHeardMux = portMUX_INITIALIZER_UNLOCKED;

bool viewerBlinkActive = false;  // the page on screen is a forecast: loop() blinks it
bool viewerBlinkOn = true;
unsigned long viewerBlinkAtMs = 0;
CRGB viewerFrame[NUM_LEDS];

int viewerTypeIndex(const char *id) {
  for (uint8_t i = 0; i < VIEWER_TYPE_COUNT; i++) {
    if (strcmp(VIEWER_TYPES[i].id, id) == 0) return i;
  }
  return -1;
}

// type < 0: any type (configs saved before devices were dynamic).
int viewerFieldIndex(int type, const char *id) {
  for (uint8_t i = 0; i < VIEWER_FIELD_COUNT; i++) {
    if ((type < 0 || VIEWER_FIELDS[i].type == type) && strcmp(VIEWER_FIELDS[i].id, id) == 0) return i;
  }
  return -1;
}

// XOR over every byte except the checksum byte - what Daffodil and Langley send (calculateChecksum).
bool viewerChecksumOk(const uint8_t *p, size_t len, size_t checksumOffset) {
  uint8_t x = 0;
  for (size_t i = 0; i < len; i++) {
    if (i != checksumOffset) x ^= p[i];
  }
  return x == p[checksumOffset];
}

// processLora(): a packet from a device the viewer can show. Keeps it under the device's name -
// replacing that device's previous packet, else an empty entry, else the device heard longest ago.
// Display only, never acted on, so no TOTP check (Chinampa doesn't fill totpcode or checksum).
void viewerRecord(uint8_t type, const char *name, size_t nameLen, const void *data, size_t len) {
  if (digitalStablesData.currentFunctionValue != DAFFODIL_VIEWER) return;
  char n[VIEWER_NAME_LEN];
  size_t k = 0;
  for (; k < nameLen && k < VIEWER_NAME_LEN - 1 && name[k]; k++) {
    n[k] = (name[k] >= 32 && name[k] < 127 && name[k] != '"' && name[k] != '\\') ? name[k] : '?';  // goes into JSON
  }
  n[k] = 0;
  if (k == 0) strcpy(n, "?");
  long now = codeTimeNow();
  portENTER_CRITICAL(&viewerHeardMux);
  int slot = -1, oldest = 0;
  for (int i = 0; i < VIEWER_MAX_DEVICES; i++) {
    if (viewerHeard[i].at != 0 && viewerHeard[i].type == type && strcmp(viewerHeard[i].name, n) == 0) {
      slot = i;
      break;
    }
    if (viewerHeard[i].at < viewerHeard[oldest].at) oldest = i;  // an empty entry (at 0) wins
  }
  if (slot < 0) slot = oldest;
  ViewerHeard &h = viewerHeard[slot];
  h.at = now;
  h.rssi = (int16_t)loraRxRssi;
  h.type = type;
  strcpy(h.name, n);
  memset(h.raw, 0, sizeof(h.raw));
  memcpy(h.raw, data, len);
  portEXIT_CRITICAL(&viewerHeardMux);
  if (debug) Serial.printf(" viewer: heard %s %s (%d dBm)\n", VIEWER_TYPES[type].name, n, (int)loraRxRssi);
}

// The newest entry of the type (and name, unless name is ""), or -1. Caller holds the lock.
int viewerFindLocked(uint8_t type, const char *name) {
  int best = -1;
  for (int i = 0; i < VIEWER_MAX_DEVICES; i++) {
    const ViewerHeard &h = viewerHeard[i];
    if (h.at == 0 || h.type != type || (name[0] && strcmp(h.name, name) != 0)) continue;
    if (best < 0 || h.at > viewerHeard[best].at) best = i;
  }
  return best;
}

// Copies the device's last packet into raw; ageSec = how long ago it was heard. False if never heard.
bool viewerPacket(uint8_t type, const char *name, uint8_t *raw, long &ageSec) {
  portENTER_CRITICAL(&viewerHeardMux);
  int i = viewerFindLocked(type, name);
  if (i >= 0) {
    memcpy(raw, viewerHeard[i].raw, VIEWER_RAW_MAX);
    ageSec = codeTimeNow() - viewerHeard[i].at;
  }
  portEXIT_CRITICAL(&viewerHeardMux);
  return i >= 0;
}

bool viewerFreshPacket(uint8_t type, const char *name, uint8_t *raw) {
  long age;
  return viewerPacket(type, name, raw, age) && age <= (long)viewerCfg.staleSec;
}

// Parses and validates a config JSON into out. Returns an error message, "" when valid.
String viewerParseConfig(const String &json, ViewerConfig &out) {
  JsonDocument doc;
  if (deserializeJson(doc, json)) return "invalid JSON";
  JsonArray pages = doc["pages"].as<JsonArray>();
  // No pages is valid (2026-11-07): a new Viewer starts empty and pages are added from the devices
  // it actually hears - the LEDs show the "no data" dot until then.
  if (pages.size() > VIEWER_MAX_PAGES) return "more than " + String(VIEWER_MAX_PAGES) + " pages";
  const char *legacySource = doc["src"] | "";  // before 2026-11-07: one Chinampa name for all pages
  ViewerConfig c;
  for (JsonObject p : pages) {
    int type = -1;
    if (p["t"].is<const char *>()) {
      type = viewerTypeIndex(p["t"]);
      if (type < 0) return "unknown device type " + String((const char *)p["t"]);
    }
    const char *f = p["f"] | "";
    int fi = viewerFieldIndex(type, f);
    if (fi < 0) return "unknown field " + String(f);
    int s = p["s"] | 0;
    if (s < 0 || s > 2) return "slot must be 0, 1 or 2";
    const char *d = p["d"] | (type < 0 && VIEWER_FIELDS[fi].type == VIEWER_TYPE_CHINAMPA ? legacySource : "");
    if (VIEWER_FIELDS[fi].type == VIEWER_TYPE_FORECAST) d = "";
    if (strlen(d) >= VIEWER_NAME_LEN) return "device name too long";
    c.field[c.count] = fi;
    c.slot[c.count] = s;
    strlcpy(c.device[c.count], d, VIEWER_NAME_LEN);
    c.count++;
  }
  c.staleSec = doc["stale"] | 600;
  c.frost = doc["frost"] | 0.0f;
  out = c;
  return "";
}

void viewerConfigToJson(const ViewerConfig &c, JsonObject o) {
  o["stale"] = c.staleSec;
  o["frost"] = c.frost;
  JsonArray pages = o["pages"].to<JsonArray>();
  for (uint8_t i = 0; i < c.count; i++) {
    JsonObject p = pages.add<JsonObject>();
    p["t"] = VIEWER_TYPES[VIEWER_FIELDS[c.field[i]].type].id;
    if (c.device[i][0]) p["d"] = c.device[i];
    p["f"] = VIEWER_FIELDS[c.field[i]].id;
    if (c.slot[i]) p["s"] = c.slot[i];
  }
}

void viewerLoadConfig() {
  Preferences p;
  String json = "";
  if (p.begin("Viewer", true)) {
    json = p.getString("cfg", "");
    p.end();
  }
  if (json.length() == 0 || viewerParseConfig(json, viewerCfg) != "") viewerParseConfig(VIEWER_DEFAULT_CONFIG, viewerCfg);
}

// Web (async_tcp task) and serial: validate, save, and hand to loop() to apply. "" = accepted.
String viewerSetConfig(const String &json) {
  ViewerConfig c;
  String err = viewerParseConfig(json, c);
  if (err != "") return err;
  JsonDocument doc;
  viewerConfigToJson(c, doc.to<JsonObject>());
  String normalized;
  serializeJson(doc, normalized);
  Preferences p;
  p.begin("Viewer", false);
  p.putString("cfg", normalized);
  p.end();
  viewerPendingCfg = c;
  viewerCfgPending = true;
  return "";
}

void viewerPageReading(uint8_t page, JsonObject r);

// GetViewerConfig: the config, every device type with its fields, what each page shows now, and the
// devices heard so far.
void fillViewerData(JsonDocument &json) {
  viewerConfigToJson(viewerCfg, json["config"].to<JsonObject>());
  JsonArray types = json["types"].to<JsonArray>();
  for (uint8_t t = 0; t < VIEWER_TYPE_COUNT; t++) {
    JsonObject to = types.add<JsonObject>();
    to["t"] = VIEWER_TYPES[t].id;
    to["name"] = VIEWER_TYPES[t].name;
    JsonArray fields = to["fields"].to<JsonArray>();
    for (uint8_t i = 0; i < VIEWER_FIELD_COUNT; i++) {
      if (VIEWER_FIELDS[i].type != t) continue;
      JsonObject f = fields.add<JsonObject>();
      f["id"] = VIEWER_FIELDS[i].id;
      f["label"] = VIEWER_FIELDS[i].label;
      f["glyph"] = VIEWER_FIELDS[i].glyph == VIEWER_GLYPH_TEMPERATURE ? "temperature" : VIEWER_FIELDS[i].glyph == VIEWER_GLYPH_LEVEL ? "level" : "flow";
    }
  }
  JsonArray readings = json["readings"].to<JsonArray>();
  for (uint8_t p = 0; p < viewerCfg.count; p++) viewerPageReading(p, readings.add<JsonObject>());
  JsonArray devices = json["devices"].to<JsonArray>();
  if (secondsSinceLastWeatherData < 9999) {
    JsonObject d = devices.add<JsonObject>();
    d["t"] = VIEWER_TYPES[VIEWER_TYPE_FORECAST].id;
    d["d"] = "";
    d["ageSec"] = secondsSinceLastWeatherData;
  }
  ViewerHeard copy[VIEWER_MAX_DEVICES];
  portENTER_CRITICAL(&viewerHeardMux);
  for (int i = 0; i < VIEWER_MAX_DEVICES; i++) {  // names and times only - the packets stay put
    copy[i].at = viewerHeard[i].at;
    copy[i].rssi = viewerHeard[i].rssi;
    copy[i].type = viewerHeard[i].type;
    memcpy(copy[i].name, viewerHeard[i].name, VIEWER_NAME_LEN);
  }
  portEXIT_CRITICAL(&viewerHeardMux);
  long now = codeTimeNow();
  for (int i = 0; i < VIEWER_MAX_DEVICES; i++) {
    if (copy[i].at == 0 || copy[i].type >= VIEWER_TYPE_COUNT) continue;
    JsonObject d = devices.add<JsonObject>();
    d["t"] = VIEWER_TYPES[copy[i].type].id;
    d["d"] = copy[i].name;
    d["ageSec"] = now - copy[i].at;
    d["rssi"] = copy[i].rssi;
  }
}

// GetViewerConfig "readings": what each page shows, for the web page's data card (2026-11-07).
// {"ok":true,"v":14.2,"ageSec":20,"stale":false,"state":"low|ok|high|flowing|stopped|frost"}
// ok false = never heard / no reading.
bool viewerForecastValue(uint8_t fi, float &t);
bool viewerFieldValue(uint8_t fi, const uint8_t *raw, float &t, CRGB &col);
void viewerPageReading(uint8_t page, JsonObject r) {
  uint8_t fi = viewerCfg.field[page];
  const ViewerField &fd = VIEWER_FIELDS[fi];
  float t = 0;
  CRGB col;
  bool ok;
  long age = 0;
  if (fd.type == VIEWER_TYPE_FORECAST) {
    ok = viewerForecastValue(fi, t);
    age = secondsSinceLastWeatherData;
    if (ok && t <= viewerCfg.frost) r["state"] = "frost";
  } else {
    uint8_t *raw = (uint8_t *)malloc(VIEWER_RAW_MAX);  // async_tcp task: keep it off its small stack
    ok = raw && viewerPacket(fd.type, viewerCfg.device[page], raw, age) && viewerFieldValue(fi, raw, t, col);
    free(raw);
    if (ok && fd.glyph == VIEWER_GLYPH_LEVEL) r["state"] = col.r ? "low" : col.b ? "high" : "ok";
    if (ok && fd.glyph == VIEWER_GLYPH_FLOW) r["state"] = t > 0 ? "flowing" : "stopped";
    if (ok) r["stale"] = age > (long)viewerCfg.staleSec;
  }
  r["ok"] = ok;
  if (ok) {
    r["v"] = round(t * 10) / 10.0;
    r["ageSec"] = age;
  }
}

// Forecast fields. secondsTime is the OWM UTC timestamp, hour the local hour (WeatherForecastManager).
// "Next morning" = lowest temperature among forecast slots at local 03-09h within 24 h of the first
// slot. The 8-slot forecast (24 h, 2026-11-07) has it all day; from a 4-slot one (12 h) only from ~8 pm.
bool viewerForecastValue(uint8_t fi, float &t) {
  if (secondsSinceLastWeatherData > 43200 || !weatherForecastManager->hasValidForecasts()) return false;
  WeatherForecast *f = weatherForecastManager->getForecasts();
  if (fi == VF_FORECAST_NEXT) {
    t = f[0].temperature;
    return true;
  }
  bool found = false;
  for (uint8_t i = 0; i < 8; i++) {
    if (f[i].secondsTime < f[0].secondsTime || f[i].secondsTime >= f[0].secondsTime + 86400) continue;
    if (f[i].hour < 3 || f[i].hour > 9) continue;
    if (!found || f[i].temperature < t) t = f[i].temperature;
    found = true;
  }
  return found;
}

// Same 3-zone rule as Water Trough: measured is the sonar distance down to the surface, so the
// water level is height - measured. Red below the minimum level, blue above the maximum, else green.
bool viewerLevelColor(float measured, float height, float minLevel, float maxLevel, CRGB &c, float &level) {
  if (measured <= 0 || height <= 0) return false;  // -99 = no reading
  level = height - measured;
  c = level < minLevel ? CRGB(255, 0, 0) : level > maxLevel ? CRGB(0, 0, 255) : CRGB(0, 255, 0);
  return true;
}

// A device field's value from its last packet: t = the temperature (C), water level (cm) or flow
// rate; col = the level/flow colour. False when the packet has no reading for it.
bool viewerFieldValue(uint8_t fi, const uint8_t *raw, float &t, CRGB &col) {
  switch (VIEWER_FIELDS[fi].type) {
    case VIEWER_TYPE_CHINAMPA:
      {
        ChinampaData c;
        memcpy(&c, raw, sizeof(c));
        switch (fi) {
          case VF_CH_OUTDOOR_TEMP: t = c.outdoortemperature; return t != -99;
          case VF_CH_SUMP_LEVEL: return viewerLevelColor(c.sumpTroughMeasuredHeight, c.sumpTroughHeight, c.minimumSumpTroughLevel, c.maximumSumpTroughLevel, col, t);
          case VF_CH_FISH_LEVEL: return viewerLevelColor(c.fishTankMeasuredHeight, c.fishTankHeight, c.minimumFishTankLevel, c.maximumFishTankLevel, col, t);
          case VF_CH_FISH_OUTFLOW: t = c.fishtankoutflowflowRate; break;
          case VF_CH_PUMP_FLOW: t = c.pumpflowRate; break;
          default: return false;
        }
        break;
      }
    case VIEWER_TYPE_DAFFODIL:
      {
        DigitalStablesData d;
        memcpy(&d, raw, sizeof(d));
        switch (fi) {
          case VF_DA_OUTDOOR_TEMP: t = d.outdoortemperature; return t != -99;
          case VF_DA_WATER_TEMP:  // only that mode puts the water temperature in measuredHeight2
            t = d.measuredHeight2;
            return d.currentFunctionValue == DAFFODIL_WATER_TROUGH_WATER_TEMP && t != -99;
          case VF_DA_TROUGH_LEVEL: return viewerLevelColor(d.measuredHeight, d.maximumScepticHeight, d.troughlevelminimumcm, d.troughlevelmaximumcm, col, t);
          case VF_DA_FLOW1: t = d.flowRate; break;
          case VF_DA_FLOW2: t = d.flowRate2; break;
          default: return false;
        }
        break;
      }
    case VIEWER_TYPE_LANGLEY:
      {
        LangleyData l;
        memcpy(&l, raw, sizeof(l));
        if (fi != VF_LA_TEMP) return false;
        t = l.temperature;
        return t != -99;
      }
    default: return false;
  }
  // Flow: blue while flowing, red when stopped.
  if (t < 0) return false;
  col = t > 0 ? CRGB(0, 0, 255) : CRGB(255, 0, 0);
  return true;
}

void drawViewerPage(uint8_t page) {
  for (int i = 0; i < NUM_LEDS; i++) leds[i] = CRGB(0, 0, 0);
  if (page >= viewerCfg.count) {  // no pages configured yet
    leds[7] = CRGB(255, 0, 0);
    viewerBlinkActive = false;
    FastLED.show();
    return;
  }
  uint8_t fi = viewerCfg.field[page];
  uint8_t slot = viewerCfg.slot[page];
  const ViewerField &fd = VIEWER_FIELDS[fi];
  bool ok = false;
  float t = 0;
  CRGB col;
  if (fd.type == VIEWER_TYPE_FORECAST) {
    if (viewerForecastValue(fi, t)) {
      // At or below the frost threshold = blue (frost); otherwise the usual sign colours.
      CRGB tc = t <= viewerCfg.frost ? CRGB(0, 0, 255) : t > 0 ? CRGB(0, 255, 0) : CRGB(255, 255, 0);
      drawTemperatureValue(t, tc.r, tc.g, tc.b);
      ok = true;
    }
  } else {
    static uint8_t raw[VIEWER_RAW_MAX];  // static: loop() only, keeps ~250 B off the stack
    if (viewerFreshPacket(fd.type, viewerCfg.device[page], raw) && viewerFieldValue(fi, raw, t, col)) {
      if (fd.glyph == VIEWER_GLYPH_TEMPERATURE) {
        CRGB tc = t > 0 ? CRGB(0, 255, 0) : t < 0 ? CRGB(0, 0, 255) : CRGB(255, 255, 0);
        drawTemperatureValue(t, tc.r, tc.g, tc.b);
      } else if (fd.glyph == VIEWER_GLYPH_LEVEL) {
        drawTower(col, slot != 0);
      } else {
        drawFlowSymbol(col);
      }
      ok = true;
    }
  }
  if (!ok) {
    for (int i = 0; i < NUM_LEDS; i++) leds[i] = CRGB(0, 0, 0);
    leds[7] = CRGB(255, 0, 0);  // nothing current to show for this page (never heard, stale, no reading)
  }
  if (fd.glyph != VIEWER_GLYPH_TEMPERATURE) {
    if (slot == 1) leds[4] = CRGB(0, 0, 255);
    if (slot == 2) leds[14] = CRGB(0, 0, 255);
  }
  memcpy(viewerFrame, leds, sizeof(viewerFrame));
  viewerBlinkActive = ok && fd.type == VIEWER_TYPE_FORECAST;
  viewerBlinkOn = true;
  viewerBlinkAtMs = millis();
  FastLED.show();
}

// listenForReplies(): every device a page shows has been heard since `since` (forecast pages
// don't count - the weather has its own rule there).
bool viewerPagesHeardSince(long since) {
  bool all = true;
  portENTER_CRITICAL(&viewerHeardMux);
  for (uint8_t p = 0; p < viewerCfg.count && all; p++) {
    uint8_t type = VIEWER_FIELDS[viewerCfg.field[p]].type;
    if (type == VIEWER_TYPE_FORECAST) continue;
    int i = viewerFindLocked(type, viewerCfg.device[p]);
    all = i >= 0 && viewerHeard[i].at >= since;
  }
  portEXIT_CRITICAL(&viewerHeardMux);
  return all;
}

// loop(): forecast pages blink, 0.5 s on / 0.5 s off.
void viewerBlinkTick() {
  if (!viewerBlinkActive || millis() - viewerBlinkAtMs < 500) return;
  viewerBlinkAtMs = millis();
  viewerBlinkOn = !viewerBlinkOn;
  if (viewerBlinkOn) memcpy(leds, viewerFrame, sizeof(viewerFrame));
  else
    for (int i = 0; i < NUM_LEDS; i++) leds[i] = CRGB(0, 0, 0);
  FastLED.show();
}

void processLora(int packetSize) {
  if (debug) Serial.print(" Receive lora: ");
  if (debug) Serial.println(packetSize);

  if (debug) Serial.print(" size of ds: ");
  if (debug) Serial.print(sizeof(DigitalStablesData));

  if (debug) Serial.print(" WeatherForecastUpdate: ");
  if (debug) Serial.print(sizeof(WeatherForecastUpdate));

  if (debug) Serial.print(" s RequestCommand: ");
  if (debug) Serial.println(sizeof(RequestCommand));

  if (packetSize == 0) return;  // if there's no packet, return


  if (packetSize == sizeof(DigitalStablesData)) {
    DigitalStablesData receivedDigitalStablesData;
    loraRxRead((uint8_t *)&receivedDigitalStablesData, sizeof(DigitalStablesData));
    long commandcode = receivedDigitalStablesData.totpcode;
    bool validCode = secretManager.checkCode(commandcode, timeManager.getTimeForCodeGeneration(currentTimerRecord));

    if (debug) Serial.print(" Received DigitalStablesData code  : ");
    if (debug) Serial.print(commandcode);
    String receivedSerialNumber = DeviceSerial::toString(receivedDigitalStablesData.serialnumberarray);

    if (debug) Serial.print(" sn  : ");
    if (debug) Serial.print(receivedSerialNumber);
    if (receivedSerialNumber == serialNumber) {
      if (debug) Serial.println("Ignored self reception");
    } else {
      // Viewer: any Daffodil with a good checksum - display only, so no TOTP needed (another
      // site's Daffodil can have a different secret).
      if (receivedDigitalStablesData.checksum == calculateChecksum(receivedDigitalStablesData)) {
        viewerRecord(VIEWER_TYPE_DAFFODIL, receivedDigitalStablesData.devicename, sizeof(receivedDigitalStablesData.devicename),
                     &receivedDigitalStablesData, sizeof(DigitalStablesData));
      }
      if (validCode) {

        // secretManager.saveSleepPingMinutes(rosieConfigData.sleepPingMinutes);
        // secretManager.saveConfigData(rosieConfigData.fieldId,  stationName );

        int rssi = loraRxRssi;
        float Snr = loraRxSnr;
        if (debug) Serial.print(" valid code ");
        if (debug) Serial.print("  from: ");
        if (debug) Serial.println(receivedDigitalStablesData.devicename);
      } else {
        long currentcode = secretManager.generateCode(timeManager.getTimeForCodeGeneration(currentTimerRecord));
        if (debug) Serial.print(" Receive digitalStablesData but invalid code: ");
        if (debug) Serial.print(commandcode);
        if (debug) Serial.print(" currentcode: ");
        if (debug) Serial.println(currentcode);
      }
    }

  } else if (packetSize == sizeof(RequestCommand)) {
    RequestCommand rc;
    loraRxRead((uint8_t *)&rc, sizeof(RequestCommand));
    long totpcode = rc.totpcode;
    bool validCode = secretManager.checkCode(totpcode, timeManager.getTimeForCodeGeneration(currentTimerRecord));
    if (validCode) {
      String commandcode = String(rc.commandString);
      if (commandcode == "SendAsyncData") {
        if (debug) Serial.println("received SEND_ASYNC_DATA");

        // void sendDataViaLoRa() {
        // Read all stored data
        const int MAX_RECORDS = 10;  // Adjust based on your memory constraints
        DigitalStablesData dataArray[MAX_RECORDS];
        int actualSize = 0;
        if (!dataManager.readAllDSDData(dataArray, MAX_RECORDS, actualSize)) {
          if (debug) Serial.println("No data to send or error reading data");
          RequestCommand rc;
          rc.totpcode = secretManager.generateCode(timeManager.getTimeForCodeGeneration(currentTimerRecord));
          rc.setCommand("NoData");
          sendMessage(rc,false);
        }
        if (debug) Serial.printf("Sending %d records via LoRa...\n", actualSize);

        // Send each record as binary data
        for (int i = 0; i < actualSize; i++) {
          dataArray[i].totpcode = secretManager.generateCode(timeManager.getTimeForCodeGeneration(currentTimerRecord));
          sendMessage(dataArray[i],false);
          // LoRa.endPacket();
          if (debug) Serial.printf("Sent record %d/%d (%d bytes)\n",
                                   i + 1, actualSize, sizeof(DigitalStablesData) + 2);  // +2 for marker and index
          // Brief delay to avoid overwhelming the receiver
          delay(200);
        }
        if (debug) Serial.println("All data sent");
        //}


      } else if (commandcode == "ReceivedOK") {
        if (debug) Serial.println("received RECEIVED_OK");
      } else if (commandcode == "ClearedOk") {
        if (debug) Serial.println("received CLEARED_OK");
      } else if (commandcode == "NoData") {
        if (debug) Serial.println("received NO_DATA");
      } else if (commandcode == "SendCurrentData") {
        if (debug) Serial.println("received SendCurrentData, sending ..");
        sendMessage(digitalStablesData,false);
      }
    } else {
      if (debug) Serial.print(" Receive RequestCommand but invalid code: ");
      if (debug) Serial.println(totpcode);
    }
  } else if (packetSize == sizeof(DeviceCommandRecord)) {
    DeviceCommandRecord deviceCommand;
    loraRxRead((uint8_t *)&deviceCommand, sizeof(DeviceCommandRecord));
    if (isBroadcastPing(deviceCommand.serialnumberarray, deviceCommand.command)) {
      handlePing(deviceCommand);  // Paula's signal survey - see handlePing
      return;
    }
    bool accepted = acceptDeviceCommand(deviceCommand);
    if (debug) Serial.printf(" DeviceCommand %u (%u min) from sender %u: %s\n", deviceCommand.command,
                             deviceCommand.minutes, deviceCommand.sender, accepted ? "accepted" : "ignored");
  } else if (packetSize == sizeof(WeatherForecast8Update)) {
    // 8 slots, 24 h (2026-11-07) - see SolarPowerData.h.
    WeatherForecast8Update update8;
    loraRxRead((uint8_t *)&update8, sizeof(update8));
    if (acceptAnnabelleTime(update8.annabelleTime, update8.totpcode, update8.flags)) {
      WeatherForecast f[WEATHER_FORECAST8_SLOTS];
      for (int i = 0; i < WEATHER_FORECAST8_SLOTS; i++) f[i] = weatherForecastFromSlot(update8.forecasts[i]);
      rtc_weatherRssi = (int16_t)loraRxRssi;
      rtc_weatherSnrQ = (int8_t)lroundf(loraRxSnr * 4);
      weatherForecastManager->saveForecasts(f, WEATHER_FORECAST8_SLOTS);
      solarInfo->setWeatherForecast(f, WEATHER_FORECAST8_SLOTS);
      markWeatherReceived();
      rtc_lastWeather8Epoch = rtc_lastWeatherEpoch;
      if (debug) Serial.println(" Receive and processed 8-slot weatherForecast ");
    } else if (debug) {
      Serial.println(" Receive WeatherForecast8Update but not accepted");
    }
  } else if (packetSize == sizeof(WeatherForecastUpdate) && rtc_lastWeather8Epoch != 0
             && (long)timeManager.getCurrentTimeInSeconds(currentTimerRecord) - (long)rtc_lastWeather8Epoch < WEATHER8_PREFERRED_SEC) {
    // The 4-slot copy Annabelle sends right after the 8-slot one, for older receivers.
    if (debug) Serial.println(" 4-slot weatherForecast ignored - have the 8-slot one");
  } else if (packetSize == sizeof(WeatherForecastUpdate)) {
    WeatherForecastUpdate weatherForecastUpdate;
    loraRxRead((uint8_t *)&weatherForecastUpdate, sizeof(WeatherForecastUpdate));
    long commandcode = weatherForecastUpdate.totpcode;
    bool validCode = acceptAnnabelleTime(weatherForecastUpdate.annabelleTime, weatherForecastUpdate.totpcode, weatherForecastUpdate.flags);  // also sets the RTC from Annabelle's time
    if (validCode) {
      rtc_weatherRssi = (int16_t)loraRxRssi;
      rtc_weatherSnrQ = (int8_t)lroundf(loraRxSnr * 4);
      //WeatherForecast forecasts=weatherForecastUpdate.forecasts;
      weatherForecastManager->saveForecasts(weatherForecastUpdate.forecasts, 4);  // the packet carries 4; the default 8 copied 160 bytes past the array
      solarInfo->setWeatherForecast(weatherForecastUpdate.forecasts, 4);
      markWeatherReceived();
      if (debug) Serial.println(" Receive and processed weatherForecast ");
    } else {
      if (debug) Serial.print(" Receive WeatherForecastUpdate but invalid code: ");
      if (debug) Serial.println(commandcode);
    }
  } else if (packetSize == sizeof(ChinampaData)) {
    // Chinampa fills neither totpcode nor checksum (checked 2026-11-06): nothing to check.
    ChinampaData c;
    loraRxRead((uint8_t *)&c, sizeof(c));
    viewerRecord(VIEWER_TYPE_CHINAMPA, c.devicename, sizeof(c.devicename), &c, sizeof(c));
  } else if (packetSize == sizeof(LangleyData)) {
    LangleyData l;
    loraRxRead((uint8_t *)&l, sizeof(l));
    if (viewerChecksumOk((const uint8_t *)&l, sizeof(l), offsetof(LangleyData, checksum))) {
      viewerRecord(VIEWER_TYPE_LANGLEY, l.devicename, sizeof(l.devicename), &l, sizeof(l));
    } else if (debug) {
      Serial.println(" LangleyData with a bad checksum - ignored");
    }
  } else {  //if(packetSize==14){
    if (debug) Serial.println("\n--- RECEIVED unknown size  PACKET ---");
    // Create a buffer to store the received bytes
    uint8_t buffer[packetSize];
    // Read all bytes into the buffer
    for (int i = 0; i < packetSize; i++) {
      buffer[i] = loraRxByte();
    }
    // Display as hex values (with position)
    if (debug) Serial.print("HEX: ");
    for (int i = 0; i < packetSize; i++) {
      // Print position
      if (debug) Serial.print("[");
      if (debug) Serial.print(i);
      if (debug) Serial.print("]");
      // Print hex value with leading zero if needed
      if (buffer[i] < 16)
        if (debug) Serial.print("0");
      if (debug) Serial.print(buffer[i], HEX);
      if (debug) Serial.print(" ");
    }
    if (debug) Serial.println();
    // Display as ASCII (printable characters only)
    if (debug) Serial.print("ASCII: ");
    for (int i = 0; i < packetSize; i++) {
      // Check if it's a printable ASCII character (32-126)
      if (buffer[i] >= 32 && buffer[i] <= 126) {
        if (debug) Serial.print((char)buffer[i]);
      } else {
        if (debug) Serial.print(".");  // Non-printable character
      }
    }
    if (debug) Serial.println();
    // Display as decimal values
    if (debug) Serial.print("DEC: ");
    for (int i = 0; i < packetSize; i++) {
      if (debug) Serial.print("[");
      if (debug) Serial.print(i);
      if (debug) Serial.print("]");
      if (debug) Serial.print(buffer[i]);
      if (debug) Serial.print(" ");
    }
    if (debug) Serial.println();
    // Try to interpret as common data types
    if (packetSize >= 4) {
      // As 32-bit integer (little endian)
      int32_t int32Value = buffer[0] | (buffer[1] << 8) | (buffer[2] << 16) | (buffer[3] << 24);
      if (debug) Serial.print("As Int32 (LE): ");
      if (debug) Serial.println(int32Value);
      // As 32-bit float (little endian)
      float floatValue;
      memcpy(&floatValue, buffer, 4);
      if (debug) Serial.print("As Float (LE): ");
      if (debug) Serial.println(floatValue);
    }
    // Calculate a simple checksum to see if it's consistent
    uint8_t checksum = 0;
    for (int i = 0; i < packetSize - 1; i++) {
      checksum ^= buffer[i];  // XOR checksum
    }
    if (debug) Serial.print("Last byte: ");
    if (debug) Serial.print(buffer[packetSize - 1]);
    if (debug) Serial.print(", XOR Checksum: ");
    if (debug) Serial.println(checksum);
    if (debug) Serial.println("--- END OF PACKET ANALYSIS ---\n");
  }
}
void LoRa_txMode() {
  LoRa.idle();             // set standby mode
  LoRa.disableInvertIQ();  // normal mode
}
void LoRa_rxMode() {
  LoRa.disableInvertIQ();  // normal mode
  LoRa.receive();          // set receive mode
}

LoRaError performCAD() {

  if (!loraActive) {
    return LORA_INIT_FAILED;
  }

  // 1. Prepare for a clean reading
  LoRa.idle();
  LoRa.receive();

  // 2. Faster Sampling
  // We reduce the delay and sample count to minimize "blind time"
  const int SAMPLES = 4;
  float rssiSum = 0;

  for (int i = 0; i < SAMPLES; i++) {
    rssiSum += LoRa.rssi();
    delayMicroseconds(500);  // Very fast check
  }

  avgRssi = rssiSum / SAMPLES;

  // 3. Forgiving Threshold
  // -50 allows operation in high-noise indoor environments.
  // Restore to -85 for outdoor/greenhouse deployment where a real LoRa
  // neighbour on-channel should block transmission.
  if (avgRssi > -50) {
    if (debug) {
      Serial.print("Channel Busy! RSSI: ");
      Serial.println(avgRssi);
    }
    LoRa.idle();
    return LORA_CHANNEL_BUSY;
  }

  // Clear for transmission
  if (debug) {
    Serial.print("Channel Clear. RSSI: ");
    Serial.println(avgRssi);
  }

  errorManager.clearLoRaError(LORA_CHANNEL_BUSY);
  return LORA_OK;
}



void print_wakeup_reason() {
  esp_sleep_wakeup_cause_t wakeup_reason;
  wakeup_reason = esp_sleep_get_wakeup_cause();

  switch (wakeup_reason) {
    case ESP_SLEEP_WAKEUP_EXT0:
      if (debug) Serial.println("Wakeup caused by button press");
      // Do something specific when button wakes the device
      break;
    case ESP_SLEEP_WAKEUP_TIMER:
      if (debug) Serial.println("Wakeup caused by timer");
      // Do something specific when timer wakes the device
      break;
    default:
      if (debug) Serial.println("First boot or reset");
      break;
  }
}

void listFiles(const char *dirname) {
  Serial.printf("Listing directory: %s\n", dirname);

  File root = LittleFS.open(dirname);
  if (!root) {
    Serial.println("Failed to open directory");
    return;
  }
  if (!root.isDirectory()) {
    Serial.println("Not a directory");
    return;
  }

  File file = root.openNextFile();
  while (file) {
    if (file.isDirectory()) {
      Serial.print("  DIR : ");
      Serial.println(file.name());
    } else {
      Serial.print("  FILE: ");
      Serial.print(file.name());
      Serial.print("\tSIZE: ");
      Serial.println(file.size());
    }
    file = root.openNextFile();
  }
}

void resetI2CDevices() {
  Wire.beginTransmission(0x00); // General Call Address
  Wire.write(0x06);             // Reset command code
  Wire.endTransmission();
  delay(10);                    // Give devices time to reset
}


//
// End of Lora Functions
//
// Read INA219 bus voltage directly over I2C without library initialisation.
// Safe to call as soon as Wire.begin() has run. Returns -1 on I2C error.
// COMMA log — individual per-cycle readings (timestamp + voltage), capped at COMMA_LOG_MAX_RECORDS.
// Session context (first time, min voltage, cycle count) lives in RTC_DATA_ATTR vars above.

void appendCommaRecord(float voltage, uint32_t nowSec) {
  // Update session-level RTC vars
  if (rtc_comma_first_time == 0) rtc_comma_first_time = nowSec;
  if (voltage > 0 && voltage < rtc_comma_min_voltage) rtc_comma_min_voltage = voltage;
  rtc_comma_cycle_count++;

  CommaRecord rec;
  rec.time    = nowSec;
  rec.voltage = voltage;
  strncpy(rec.devicename, rtc_device_shortname, 7);
  rec.devicename[7] = '\0';

  File rlog = LittleFS.open(COMMA_LOG_FILE, "r");
  int existing = (rlog && rlog.size() >= sizeof(CommaRecord))
                 ? (int)(rlog.size() / sizeof(CommaRecord)) : 0;
  if (rlog) rlog.close();

  if (existing >= COMMA_LOG_MAX_RECORDS) {
    // Log full — drop the oldest record. Previously read the WHOLE log into a
    // CommaRecord[COMMA_LOG_MAX_RECORDS] stack array (650 * 31 bytes ≈ 20KB) — that overflowed
    // the ~8KB default loop-task stack the instant the log actually filled up, hard-resetting
    // the device, which then hit the exact same overflow again on every subsequent boot (the
    // oversized log file survives a reset). Stream the trim in small fixed-size chunks instead,
    // so memory use stays constant regardless of COMMA_LOG_MAX_RECORDS.
    File rd = LittleFS.open(COMMA_LOG_FILE, "r");
    File wr = LittleFS.open("/comma_log.tmp", "w");
    if (rd && wr) {
      rd.seek(sizeof(CommaRecord));  // skip the oldest record
      uint8_t chunk[sizeof(CommaRecord) * 8];
      int n;
      while ((n = rd.read(chunk, sizeof(chunk))) > 0) {
        wr.write(chunk, n);
      }
      wr.write((uint8_t*)&rec, sizeof(rec));
    }
    if (rd) rd.close();
    if (wr) wr.close();
    LittleFS.remove(COMMA_LOG_FILE);
    LittleFS.rename("/comma_log.tmp", COMMA_LOG_FILE);
  } else {
    File log = LittleFS.open(COMMA_LOG_FILE, "a");
    if (log) { log.write((uint8_t*)&rec, sizeof(rec)); log.close(); }
  }
}

void clearAllCommaRecords() {
  LittleFS.remove(COMMA_LOG_FILE);
  rtc_comma_first_time  = 0;
  rtc_comma_min_voltage = 99.0f;
  rtc_comma_cycle_count = 0;
}

// Relays the COMMA log to Annabelle as CommaRecord packets, one per call, then deletes the log.
// Called from loop() only (never setup/COMMA/goToSleep), and only while the battery is above
// minimumLEDVoltage, so the night's readings go out once the device has real headroom again.
// No ACK from Annabelle: a send that is cut short (sleep, reset) restarts from record 0 next
// time - duplicates rather than losses. Returns false when there is nothing (left) to send.
bool sendNextCommaRecord() {
  File log = LittleFS.open(COMMA_LOG_FILE, "r");
  int total = (log && log.size() >= sizeof(CommaRecord)) ? (int)(log.size() / sizeof(CommaRecord)) : 0;
  if (total == 0) {
    if (log) log.close();
    commaSendIndex = 0;
    return false;
  }
  if (commaSendIndex >= total) {
    log.close();
    LittleFS.remove(COMMA_LOG_FILE);
    if (debug) Serial.printf("CommaRecords: all %d sent, log deleted\n", total);
    commaSendIndex = 0;
    return false;
  }
  CommaRecord rec;
  log.seek(commaSendIndex * sizeof(CommaRecord));
  size_t got = log.read((uint8_t*)&rec, sizeof(CommaRecord));
  log.close();
  if (got != sizeof(CommaRecord)) {
    commaSendIndex = total;  // truncated tail - treat as done
    return true;
  }
  memcpy(rec.serialnumber, digitalStablesData.serialnumberarray, sizeof(rec.serialnumber));
  rec.index = (uint8_t)min(commaSendIndex, 255);
  rec.total = (uint8_t)min(total, 255);
  int result = sendMessage(rec, false);
  if (debug) Serial.printf("CommaRecord %d/%d v=%.3f result=%d\n", commaSendIndex + 1, total, rec.voltage, result);
  if (result == LORA_OK) {
    commaSendIndex++;
    commaSendFailures = 0;
  } else if (++commaSendFailures >= COMMA_SEND_MAX_FAILURES) {
    commaSendPaused = true;  // channel/radio trouble - try again on the next wake
  }
  return true;
}

// ─────────────────────────────────────────────────────────────────────────────────────────────
// Field time sync (Field_Time_Sync_Proposal, 2026-10-07). Annabelle's WeatherForecastUpdate
// carries its NTP-corrected time (annabelleTime, in the getTimeForCodeGeneration() convention)
// and a TOTP calculated at that time, so the packet can be authenticated whatever this RTC says.
#define TIME_SYNC_TOLERANCE_SEC 5      // correct the RTC when it is further off than this
#define TIME_SYNC_MAX_JUMP_SEC  7200   // larger jumps only after the RTC lost power (replay guard)
#define TIME_SYNC_PREFS         "timesync"
#define TIME_SYNC_LAST_KEY      "lastAnnT"

// The PCF8563 lost power since it was last set: VL bit in the seconds register, or a year that
// can't be right.
bool rtcLostPower() {
  Wire.beginTransmission(0x51);
  Wire.write(0x02);
  if (Wire.endTransmission() != 0) return false;
  Wire.requestFrom(0x51, 1);
  if (!Wire.available()) return false;
  bool vl = Wire.read() & 0x80;
  return vl || currentTimerRecord.year < 2025;
}
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
void loop() {
  uint16_t dscount;
  boolean turnOffWifi = false;
  bool wifistatus = wifiManager.getWifiStatus();
  vitalSigns.setLedgerTag(wifistatus);  // WiFi energy on the Power panel (fillPowerData)
  if (loraDio0Fired) {
    loraDio0Fired = false;
    int packetSize = LoRa.parsePacket();
    if (packetSize > 0) {
      // Copy it out and listen again immediately - see loraRxBuf. A packet still waiting to be
      // processed is replaced by the newer one (the old code lost the newer one instead).
      loraRxRssi = LoRa.packetRssi();
      loraRxSnr = LoRa.packetSnr();
      loraRxAtMs = millis();
      int n = 0;
      while (LoRa.available() && n < (int)sizeof(loraRxBuf)) loraRxBuf[n++] = (uint8_t)LoRa.read();
      loraRxLen = n;
      loraRxPos = 0;
      LoRa_rxMode();
      if (n == sizeof(DeviceCommandRecord)) {
        // A command or Paula's ping: handled now, not on the 1 s tick (2026-11-03). loraRxBuf holds one
        // packet, and Annabelle answers a ping 150 ms after it - that answer replaced the ping before
        // the tick ran (found on Langley, same structure here). Handling one is only a code check.
        processLora(n);
      } else {
        loraPacketSize = n;
        loraReceived = n > 0;
      }
    } else {
      LoRa_rxMode();  // DIO0 without a good packet (CRC error, TxDone): back to continuous receive
    }
  }
  sendPendingLinkAck(false);  // Paula's ping, answered in this unit's slot (handlePing)
  if (viewerCfgPending) {  // a new Viewer config from the web page or serial
    viewerCfg = viewerPendingCfg;
    viewerCfgPending = false;
    viewerPageIndex = 0;
  }
  viewerBlinkTick();
  if (clockTicked) {

    portENTER_CRITICAL(&mux);
    clockTicked = false;
    portEXIT_CRITICAL(&mux);
    // The ONLY RTC read in the running sketch (setup() reads it once before the first tick).
    // Everything else uses currentTimerRecord - 1 s resolution is enough, and each extra read
    // raced the core-0 ledger's INA219 traffic for the shared Wire buffer (2026-10-13: date bytes
    // replaced by INA data -> TopTank packets dated 2030-2032 with the right time of day). This
    // one read takes the same lock as the ledger, so it can't be interleaved either.
    {
      InaLock lock;
      currentTimerRecord = timeManager.now();
    }

    if (wakeSignalReceived) {
      wakeSignalReceived = false;
      digitalWrite(TPL5010_DONE, HIGH);
      delayMicroseconds(100);  // Pulse width needs to be at least 20µs
      digitalWrite(TPL5010_DONE, LOW);
    }
    //
    // generate codes so that the history is refresed
    //
    if (currentTimerRecord.second == 0) {


      if (currentTimerRecord.minute == 0) {
        //  Serial.println(F("New Hour"));
        if (currentTimerRecord.hour == 0) {
          //    Serial.println(F("New Day"));
        }
      }
    }

    if (currentTimerRecord.second % 10 == 0) {
      secretManager.generateCode(timeManager.getTimeForCodeGeneration(currentTimerRecord));
      //   Serial.print("update code history: ");
      //  long* history = secretManager.getCommandCodeHistory();
      // for (int i = 0; i < 5; i++) {
      //   Serial.print(i);
      //   Serial.print(": ");
      //   Serial.println(history[i]);
      // }
    }
    if (wakeSignalReceived) {
      // Calculate time since last wake
      unsigned long timeSinceLastWake = millis() - lastWakeTime;
      lastWakeTime = millis();

      if (debug) Serial.print("Wake signal received! Time since last wake: ");
      if (debug) Serial.print(timeSinceLastWake);
      if (debug) Serial.println(" ms");
      // Reset the flag
      wakeSignalReceived = false;
    }

    if (loraReceived) {
      loraReceived = false;
      processLora(loraPacketSize);  // from loraRxBuf - the radio has been listening since it was copied out
      // (no LoRa_rxMode() here any more: re-entering receive could cut off a packet arriving right now;
      // sendMessage() already ends in receive if processLora() replied)
    }
    secondsSinceLastDataSampling++;
    if (secondsSinceLastWeatherData < 9999) secondsSinceLastWeatherData++;
    //   Serial.println("ticked");

    viewTimer.tick();
    remoteMonitorTimer.tick();
    hourlySolarPowerData = solarInfo->calculateActualPower(currentTimerRecord);

    //
    // read the sensors
    //

    readSensorData();
    if (debug) Serial.println("linr 2219");
    //  int dsdStoredCount=dataManager.getDSDStoredCount();
    // if(dsdStoredCount>(int)(.7*MAXIMUM_STORED_RECORDS)){
    //   memoryFull=true;
    // }else{
    //   memoryFull=false;
    // }

 

    if (remoteMonitorTimer.status()) {
      remoteMonitorTimer.reset();
      if (digitalStablesData.currentFunctionValue == VOLTAGE_MONITOR && currentTimerRecord.hour >= 16 && !memoryFull) {
        digitalStablesData.asyncdata = 6;
        dataManager.storeDSDData(digitalStablesData);
        remoteMonitorTimer.reset();
      }
    }


    // if(debug)Serial.print("External Voltage=");
    //  if(debug)Serial.println(digitalStablesData.flowRate);

    if (digitalStablesData.batteryVoltage > wifiStartVoltage() && !wifistatus) {
      currentSecondsWithWifiVoltage++;
    } else {
      currentSecondsWithWifiVoltage = 0;
    }

    dscount = dsUploadTimer.tick();
    HourlySolarPowerData hourlySolarPowerData = solarInfo->calculateActualPower(currentTimerRecord);
    if (usingSolarPower) {
      if (hourlySolarPowerData.efficiency * 100 > digitalStablesData.minimumEfficiencyForLed) {
        digitalWrite(LED_CONTROL, HIGH);
        {
          // Brightness follows actual available power (darkness + battery current headroom +
          // low-voltage floor) rather than the theoretical solar-efficiency estimate — see
          // calculatePowerAwareLedBrightness(). efficiency here only gates whether the LEDs get
          // any power at all (the solar-schedule decision bit5 controls), not how bright.
          uint8_t br = calculatePowerAwareLedBrightness();
          digitalStablesData.ledBrightness = br;
          FastLED.setBrightness(br);
        }
        {
          // We're already inside the "solar should be up" branch (efficiency > minimumEfficiencyForLed),
          // so a depressed V50_I here means the panel isn't harvesting despite theoretical daylight —
          // a direct power-harvest reading, unlike lux which only measures ambient brightness.
          bool v50iSaysCloudy = foundADS
                              && digitalStablesData.v50Voltage > 0
                              && digitalStablesData.v50Voltage < v50iCloudyThreshold;
          // Wally USB/panel current — a direct current reading, immune to the leakage-floor
          // ambiguity V50_I has (see panelVoltage/panelCurrent design notes): genuinely ~0mA
          // with no real panel output, unlike voltage which can float from charger leakage.
          bool panelCurrentSaysCloudy = foundINA219Solar
                              && digitalStablesData.panelCurrent >= 0
                              && digitalStablesData.panelCurrent < panelCurrentCloudyThreshold_mA;
          bool forecastSaysCloudy = false;
          if (secondsSinceLastWeatherData < 1860) {
            WeatherForecast* forecasts = weatherForecastManager->getForecasts();
            forecastSaysCloudy = (forecasts != nullptr) && (forecasts[0].cloudiness >= cloudyThreshold);
          }
          // Forecast is a prediction, not a measurement — it must never override direct
          // evidence that the panel is actually harvesting right now. If either live sensor
          // confirms real sun (current/voltage comfortably above their cloudy thresholds),
          // ignore the forecast entirely.
          bool panelCurrentConfirmsSun = foundINA219Solar && digitalStablesData.panelCurrent >= panelCurrentCloudyThreshold_mA;
          bool v50iConfirmsSun = foundADS && digitalStablesData.v50Voltage >= v50iCloudyThreshold;
          bool liveConfirmsSun = panelCurrentConfirmsSun || v50iConfirmsSun;
          // Strongest signal of all: is the battery actually receiving net charge right now.
          // panelCurrent/V50_I measure the panel side and can misread (no panel wired up on a
          // bench rig, charger-side leakage, etc.); batteryCurrent < 0 (net current flowing
          // into the battery, per its own sign convention — see the "positive = discharging"
          // comment above) is ground truth that power IS reaching the battery, so it overrides
          // v50i/panelCurrent/forecast entirely and forces FULL_MODE.
          bool batteryChargingConfirmsSun = foundINA219 && digitalStablesData.batteryCurrent < 0;
          bool cloudy = (v50iSaysCloudy || panelCurrentSaysCloudy || (forecastSaysCloudy && !liveConfirmsSun))
                        && !batteryChargingConfirmsSun;
          digitalStablesData.operatingStatus = cloudy ? OPERATING_STATUS_CLOUDY : OPERATING_STATUS_FULL_MODE;
          // Update bit 1 (weather freshness) — all other bits set once in setup.
          if (secondsSinceLastWeatherData < 1860)
            digitalStablesData.opMode |=  0x02;
          else
            digitalStablesData.opMode &= ~0x02;
        }
        turnOffWifi = (hourlySolarPowerData.efficiency * 100 < digitalStablesData.minimumEfficiencyForWifi) && wifistatus;
      } else {
        FastLED.clear(true);
        for (int i = 0; i < NUM_LEDS; i++) {
          leds[i] = CRGB(0, 0, 0);
        }
        FastLED.show();
        digitalStablesData.ledBrightness = 0;
        digitalWrite(LED_CONTROL, LOW);
        digitalStablesData.operatingStatus = OPERATING_STATUS_NO_LED;
        if(debug)Serial.println("line 2162 turning off leds because efficiency is " + String(hourlySolarPowerData.efficiency) + " and te minimum is " + digitalStablesData.minimumEfficiencyForLed);
        turnOffWifi = true;
        //         if(dataManager.getDSDStoredCount()<MAXIMUM_STORED_RECORDS){
        //            digitalStablesData.asyncdata=8;
        //         }
        //        dataManager.storeDSDData(digitalStablesData);
      }
    } else {
      // bit5=0: prioritizing sensor-reading frequency over the solar sleep schedule — doesn't
      // mean unlimited power. If a battery is attached it still needs protecting, so brightness
      // follows the same available-power calculation as the solar branch above instead of being
      // forced to 255 regardless of battery state. (No battery at all — genuinely wall/USB
      // powered — calculatePowerAwareLedBrightness() skips the battery-current term entirely.)
      digitalWrite(LED_CONTROL, HIGH);
      uint8_t br = calculatePowerAwareLedBrightness();
      digitalStablesData.ledBrightness = br;
      FastLED.setBrightness(br);
      digitalStablesData.operatingStatus = OPERATING_STATUS_FULL_MODE;
      turnOffWifi = false;
    }






    if (debug) Serial.print("line 1990  hourlySolarPowerData.efficiency=");
    if (debug) Serial.print(hourlySolarPowerData.efficiency);
    if (debug) Serial.print(" wifistatus=");
    if (debug) Serial.println(wifistatus);
    if (debug) Serial.print(" turnOffWifi=");
    if (debug) Serial.println(turnOffWifi);

    // Relay last night's COMMA log to Annabelle once the battery has LED-level headroom.
    if (loraActive && !commaSendPaused && hasBattery &&
        digitalStablesData.batteryVoltage > minimumLEDVoltage &&
        currentTimerRecord.second % COMMA_SEND_INTERVAL_SEC == 0) {
      sendNextCommaRecord();
    }

  }  // end of the tick block



  // COMMA check in the main loop (battery may drop during active WiFi/LoRa operation). Gated on
  // hasBattery — see its declaration comment.
  if (hasBattery && !rtc_comma_mode &&
      digitalStablesData.batteryVoltage > 0 && digitalStablesData.batteryVoltage < commaVoltage) {
    if (debug) { Serial.printf("COMMA from loop at %.2fV\n", digitalStablesData.batteryVoltage); }
    rtc_comma_mode = true;
    digitalStablesData.operatingStatus = OPERATING_STATUS_COMMA;
    appendCommaRecord(digitalStablesData.batteryVoltage, digitalStablesData.secondsTime);
    goToSleep();
  }

  boolean isSleepMode = false;
  if (usingSolarPower && hourlySolarPowerData.efficiency * 100 < digitalStablesData.minimumEfficiencyForLed){
    isSleepMode = true;
      if (debug) Serial.print("line 2601 isSleepMode=true because of effciency");
  } 
  // Protect battery from over-discharge (only when a battery is actually attached)
  if (hasBattery && digitalStablesData.batteryVoltage >= commaVoltage && digitalStablesData.batteryVoltage < sleepingVoltage) {
    isSleepMode = true;
    if (debug) Serial.print("line 2604 isSleepMode=true because of low battery voltage");
  }
  // On overcast days the theoretical efficiency may still be above threshold but actual solar
  // is insufficient to sustain continuous operation. Sleep between each LoRa pulse.
  if (usingSolarPower && digitalStablesData.operatingStatus == OPERATING_STATUS_CLOUDY){
     isSleepMode = true;
      if (debug) Serial.print("line 2609 isSleepMode=true because of is cloudy");
  }
  // WiFi on demand keeps it awake (the floor is above sleepingVoltage, so a low cell still sleeps).
  if (isSleepMode && wifiOnDemandAllowed(digitalStablesData.batteryVoltage)) isSleepMode = false;
  if (isSleepMode) {
    if (digitalStablesData.operatingStatus != OPERATING_STATUS_CLOUDY) {
      digitalStablesData.operatingStatus = OPERATING_STATUS_SLEEP;
    }
    if (debug) Serial.print("going to sleep, bat=");
    if (debug) Serial.print(digitalStablesData.batteryVoltage);
    if (debug) Serial.print(" efficiency=");
    if (debug) Serial.print(hourlySolarPowerData.efficiency);
    if (debug) Serial.print(" operatingStatus=");
    if (debug) Serial.println(digitalStablesData.operatingStatus);
    digitalStablesData.asyncdata = 7;
    if (dataManager.getDSDStoredCount() < MAXIMUM_STORED_RECORDS) {
      dataManager.storeDSDData(digitalStablesData);
    }
    Serial.println("Calling deepsleep line 2185");
    goToSleep();
  }



  if (hasBattery && digitalStablesData.batteryVoltage > commaVoltage && digitalStablesData.batteryVoltage < minimumLEDVoltage && digitalRead(LED_CONTROL)) {

    if (debug) Serial.print("line 967 turning off leds, battery=");
    if (debug) Serial.println(digitalStablesData.batteryVoltage);
    FastLED.clear(true);
    for (int i = 0; i < NUM_LEDS; i++) {
      leds[i] = CRGB(0, 0, 0);
    }
    FastLED.show();
    digitalStablesData.ledBrightness = 0;
    digitalWrite(LED_CONTROL, LOW);
    digitalStablesData.operatingStatus = OPERATING_STATUS_NO_LED;
  }



  // Unconditional voltage-based WiFi shutoff: if battery is below minimumWifiVoltage,
  // always call stop() — even if wifistatus is false (WiFi may be retrying and drawing current).
  if (hasBattery && digitalStablesData.batteryVoltage > commaVoltage && digitalStablesData.batteryVoltage < wifiCutVoltage()) {
    turnOffWifi = true;
  }
  // WiFi on demand overrides all of the above down to WIFI_ON_DEMAND_FLOOR_V. When it ends, WiFi
  // goes off unless the automatic rule would have started it anyway.
  bool wifiOnDemandOn = wifiOnDemandAllowed(digitalStablesData.batteryVoltage);
  if (wifiOnDemandActive() && !wifiOnDemandOn) wifiOnDemandUntil = 0;  // battery under the floor: over
  if (wifiOnDemandOn) {
    turnOffWifi = false;
  } else if (wifiOnDemandWasOn && hasBattery && digitalStablesData.batteryVoltage < wifiStartVoltage()) {
    turnOffWifi = true;
  }
  wifiOnDemandWasOn = wifiOnDemandOn;
  if (wifiOffRequested) {
    wifiOffRequested = false;
    turnOffWifi = true;
  }
  if (turnOffWifi) {
    wifiManager.stop();
    WiFi.setAutoReconnect(false);
    WiFi.disconnect(true);

    if (debug) Serial.print("turning off wifi battery voltage=");
    if (debug) Serial.println(digitalStablesData.v50Voltage);
    if (debug) Serial.print("after wifimanager stop, wifistatus=");
    if (debug) Serial.println(wifiManager.getWifiStatus());

    // Only show the disconnect animation and reset the counter once, when actually transitioning
    // from connected to disconnected. Without this guard, every tick below minimumWifiVoltage
    // would re-run the animation (red WiFi → yellow 0/14 loop visible to the user).
    if (wifistatus) {
      digitalStablesData.wifiStatus = 0;
      currentSecondsWithWifiVoltage = 0;
      FastLED.clear(true);
      for (int i = 0; i < NUM_LEDS; i++) {
        leds[i] = CRGB(0, 0, 0);
      }
      FastLED.show();
      leds[1] = CRGB(255, 0, 0);
      leds[2] = CRGB(255, 0, 0);
      leds[3] = CRGB(255, 0, 0);
      leds[5] = CRGB(255, 0, 0);
      leds[9] = CRGB(255, 0, 0);
      leds[11] = CRGB(255, 0, 0);
      leds[12] = CRGB(255, 0, 0);
      leds[13] = CRGB(255, 0, 0);
      FastLED.show();
      delay(500);
      for (int i = 0; i < NUM_LEDS; i++) {
        leds[i] = CRGB(0, 0, 0);
      }
      FastLED.show();
      FastLED.setBrightness(digitalStablesData.ledBrightness);
      leds[0] = CRGB(255, 255, 0);
      leds[14] = CRGB(255, 255, 0);
      FastLED.show();
    }
  }
  wifistatus = wifiManager.getWifiStatus();
  boolean turnOnWifi = false;
  if (!usingSolarPower) {
    // With a battery attached, use the same start rule as the solar branch (battery held above
    // minimumInitWifiVoltage for numberSecondsWithMinimumWifiVoltageForStartWifi). Without it,
    // the minimumWifiVoltage shutoff above stopped WiFi and this restarted it on every loop pass
    // whenever the battery sat below 3.28V — the AP restart loop seen on HorseTrough 2026-11-06.
    turnOnWifi = !wifistatus
              && (!hasBattery || currentSecondsWithWifiVoltage >= numberSecondsWithMinimumWifiVoltageForStartWifi);
  } else {
    turnOnWifi = (hourlySolarPowerData.efficiency * 100 > digitalStablesData.minimumEfficiencyForWifi)
              && (currentSecondsWithWifiVoltage >= numberSecondsWithMinimumWifiVoltageForStartWifi)
              && (digitalStablesData.batteryVoltage >= minimumInitWifiVoltage)
              && !wifistatus
              && codeTimeNow() >= (long)wifiAutoSuppressedUntil;  // not right after an explicit "off"
  }
  if (!wifistatus && wifiOnDemandOn) turnOnWifi = true;

  if (turnOnWifi) {
    if (debug) Serial.print("turning on  wifi");
    restartWifi();
    wifistatus = wifiManager.getWifiStatus();
  }
  // Serial.println("line 1121");
  uint8_t red = 255;
  uint8_t green = 255;
  uint8_t blue = 255;

  // Check if weather data is stale
  boolean staledata = weatherForecastManager->isWeatherDataStale(currentTimerRecord);
  // if(debug)Serial.print("l;ine 1128 staledata=");
  //  if(debug)Serial.println(staledata);
  if (staledata && wifistatus && !wifiManager.getAPStatus()) {
    // Fetch weather data and update SolarInfo
    weatherForecastManager->downloadWeatherData(solarInfo);
    markWeatherReceived();
  }
  // if(debug)Serial.println("line 1139");
  boolean showError = false;
  // Set inside SHOW_SCEPTIC when a two-slot mode just showed slot1 - keeps displayStatus on
  // SHOW_SCEPTIC for one more tick so slot2 shows immediately after, instead of advancing to
  // the other display states (temp/internet/lora/etc) and only coming back to slot2 a full
  // cycle later. Confirmed 2026-09-01: Ari wants F/led4 then F/led14 back-to-back, not
  // interspersed with the other states.
  bool holdDisplayStatus = false;
  if (viewTimer.status()) {
    showTemperature = !showTemperature;
    bool cloudySkip = (digitalStablesData.operatingStatus == OPERATING_STATUS_CLOUDY && !cloudyLedCycleOn);

    if (debug) Serial.print("battery voltage=");
    if (debug) Serial.print(digitalStablesData.v50Voltage);
    if (debug) Serial.print(" displayStatus=");
    if (debug) Serial.println(displayStatus);
    if (debug) Serial.print("line 1287 digitalStablesData.ledBrightness=");
    if (debug) Serial.print(digitalStablesData.ledBrightness);
    if (debug) Serial.print("  digitalRead(LED_CONTROL)=");
    if (debug) Serial.println(digitalRead(LED_CONTROL));

    if (!cloudySkip) {
    loraTxOk = loraActive;
    FastLED.setBrightness(digitalStablesData.ledBrightness);


    viewerBlinkActive = false;
    if (digitalStablesData.currentFunctionValue == DAFFODIL_VIEWER && (displayStatus == SHOW_TEMPERATURE || displayStatus == SHOW_SCEPTIC)) {
      // Viewer: the configured pages replace the temperature and tank states, shown back to back
      // (same hold as the two-slot modes); then the cycle carries on with internet/LoRa/error.
      if (viewerPageIndex >= viewerCfg.count) viewerPageIndex = 0;
      drawViewerPage(viewerPageIndex);
      viewerPageIndex++;
      if (viewerPageIndex < viewerCfg.count) {
        holdDisplayStatus = true;
      } else {
        viewerPageIndex = 0;
        displayStatus = SHOW_SCEPTIC;  // the displayStatus++ below moves on to internet status
      }
    } else if (displayStatus == SHOW_TEMPERATURE) {

      if (debug) Serial.print("showing temperature=");


      if (digitalStablesData.outdoortemperature == -99) {
        for (int i = 0; i < NUM_LEDS; i++) {
          leds[i] = CRGB(0, 0, 0);
        }
        leds[1] = CRGB(255, 0, 0);
        leds[2] = CRGB(255, 0, 0);
        leds[3] = CRGB(255, 0, 0);
        leds[7] = CRGB(255, 0, 0);
        leds[12] = CRGB(255, 0, 0);
        FastLED.show();
      } else {
        if (digitalStablesData.outdoortemperature > 0) {
          red = 0;
          green = 255;
          blue = 0;
        } else if (digitalStablesData.outdoortemperature < 0) {
          red = 0;
          green = 0;
          blue = 255;
        } else {
          red = 255;
          green = 255;
          blue = 0;
        }
        drawTemperature(red, green, blue);
      }
    } else if (displayStatus == SHOW_SCEPTIC) {
      for (int i = 0; i < NUM_LEDS; i++) {
        leds[i] = CRGB(0, 0, 0);
      }

      uint8_t fn = digitalStablesData.currentFunctionValue;

      if (fn == DAFFODIL_WATER_TROUGH_WATER_TEMP && showSensorSlot2) {
        // Water temperature (measuredHeight2, °C in this mode), shown right after the trough
        // tower like a two-slot mode's slot 2 (2026-11-08). Same digits and colour code as the
        // board temperature page (green > 0, blue < 0, yellow 0; red pattern = no reading), plus
        // led11 blue as the "water" marker. led11 because the slot markers led4/led14 are digit
        // pixels here; led6/led11 are the only LEDs the digits never use.
        showSensorSlot2 = false;
        float wt = digitalStablesData.measuredHeight2;
        if (wt == -99) {
          leds[1] = CRGB(255, 0, 0);
          leds[2] = CRGB(255, 0, 0);
          leds[3] = CRGB(255, 0, 0);
          leds[7] = CRGB(255, 0, 0);
          leds[12] = CRGB(255, 0, 0);
        } else {
          if (wt > 0) {
            red = 0;
            green = 255;
            blue = 0;
          } else if (wt < 0) {
            red = 0;
            green = 0;
            blue = 255;
          } else {
            red = 255;
            green = 255;
            blue = 0;
          }
          drawTemperatureValue(wt, red, green, blue);
        }
        leds[11] = CRGB(0, 0, 255);
      } else if (fn == DAFFODIL_SCEPTIC_TANK || fn == DAFFODIL_WATER_TROUGH || fn == DAFFODIL_WATER_TROUGH_WATER_TEMP || fn == DAFFODIL_SONAR_TROUGH || fn == VOLTAGE_MONITOR) {
        if (fn == DAFFODIL_WATER_TROUGH_WATER_TEMP) {
          // Trough tower now; hold so the water temperature shows on the very next tick.
          showSensorSlot2 = true;
          holdDisplayStatus = true;
        }
        // Original single-value display — untouched. scepticAvailablePercentage was dropped
        // from DigitalStablesData (purely derived, never needed on the wire) — recomputed here.
        float scepticAvailablePercentage = digitalStablesData.measuredHeight * 100 / MAX_DISTANCE;
        red = 255;
        green = 0;
        blue = 255;
        if (fn == DAFFODIL_SCEPTIC_TANK) {
          if (scepticAvailablePercentage <= 25) {
            red = 255;
            green = 0;
            blue = 0;
          } else if (scepticAvailablePercentage > 25 && scepticAvailablePercentage <= 50) {
            red = 255;
            green = 255;
            blue = 0;
          } else if (scepticAvailablePercentage > 50 && scepticAvailablePercentage <= 75) {
            red = 0;
            green = 255;
            blue = 0;
          } else if (scepticAvailablePercentage > 75) {
            red = 0;
            green = 0;
            blue = 255;
          }
        } else if (fn == DAFFODIL_WATER_TROUGH || fn == DAFFODIL_WATER_TROUGH_WATER_TEMP || fn == DAFFODIL_SONAR_TROUGH) {
          if (digitalStablesData.measuredHeight >= (digitalStablesData.maximumScepticHeight - digitalStablesData.troughlevelminimumcm)) {
            red = 255;
            green = 0;
            blue = 0;
          } else if (digitalStablesData.measuredHeight < (digitalStablesData.maximumScepticHeight - digitalStablesData.troughlevelminimumcm) && digitalStablesData.measuredHeight >= (digitalStablesData.maximumScepticHeight - digitalStablesData.troughlevelmaximumcm)) {
            red = 0;
            green = 255;
            blue = 0;
          } else if (digitalStablesData.measuredHeight < (digitalStablesData.maximumScepticHeight - digitalStablesData.troughlevelmaximumcm)) {
            red = 0;
            green = 0;
            blue = 255;
          }
        } else if (fn == VOLTAGE_MONITOR) {
          int dsdStoredCount = dataManager.getDSDStoredCount();
          if ((dsdStoredCount * 100 / MAXIMUM_STORED_RECORDS) <= 25) {
            red = 255;
            green = 0;
            blue = 0;
          } else if ((dsdStoredCount * 100 / MAXIMUM_STORED_RECORDS) > 25 && (dsdStoredCount * 100 / MAXIMUM_STORED_RECORDS) <= 50) {
            red = 255;
            green = 255;
            blue = 0;
          } else if ((dsdStoredCount * 100 / MAXIMUM_STORED_RECORDS) > 50 && (dsdStoredCount * 100 / MAXIMUM_STORED_RECORDS) <= 75) {
            red = 0;
            green = 255;
            blue = 0;
          } else if ((dsdStoredCount * 100 / MAXIMUM_STORED_RECORDS) > 75) {
            red = 0;
            green = 0;
            blue = 255;
          }
        }
        drawTower(CRGB(red, green, blue), false);

      } else if (fn == FUN_1_FLOW || fn == FUN_2_FLOW || fn == FUN_1_FLOW_1_TANK || fn == FUN_1_TANK || fn == FUN_2_TANK || fn == DAFFODIL_WATER_TROUGH_TANK1) {
        // Sensor-slot modes: slot1 = pin18/sensor1, slot2 = pin33/sensor2. A single-slot mode
        // just shows slot1 with led4 lit. A two-slot mode alternates each display cycle between
        // slot1 (led4, top-right corner) and slot2 (led14, bottom-right corner) — same
        // toggle-per-cycle pattern as showTemperature. led4/led14 are always blue: they only
        // mark which slot is currently on screen, the symbol's own color carries the actual
        // status. Both sit outside drawFlowSymbol's/drawTower's own pixels by design (grid is
        // 3 rows x 5 cols, plain row-major wiring — see drawFlowSymbol's comment) so the marker
        // can never overwrite the symbol's own status color the way led9 briefly did (confirmed
        // 2026-09-01).
        bool twoSlots = (fn == FUN_2_FLOW || fn == FUN_2_TANK || fn == FUN_1_FLOW_1_TANK || fn == DAFFODIL_WATER_TROUGH_TANK1);
        bool slot2Now = twoSlots && showSensorSlot2;
        if (twoSlots) showSensorSlot2 = !showSensorSlot2;
        // Just showed slot1 of a two-slot mode - hold here so slot2 shows on the very next
        // tick, back-to-back, instead of waiting a full outer display cycle for its turn.
        holdDisplayStatus = twoSlots && !slot2Now;

        if (!slot2Now) {
          // slot 1
          if (fn == FUN_1_FLOW || fn == FUN_2_FLOW || fn == FUN_1_FLOW_1_TANK) {
            drawFlowSymbol(flowStatusColor(digitalStablesData.flowRate));
          } else {
            // FUN_1_TANK, FUN_2_TANK, DAFFODIL_WATER_TROUGH_TANK1 — slot1 is always tank1
            // (ch1/pin18); for the trough+tank1 mode that matches the mode's own name.
            drawTower(percentBucketColor(tankPercentFull(digitalStablesData.tank1PressurePsi, digitalStablesData.tank1HeightMeters)), true);
          }
          leds[4] = CRGB(0, 0, 255);
        } else {
          // slot 2
          if (fn == FUN_2_FLOW) {
            drawFlowSymbol(flowStatusColor(digitalStablesData.flowRate2));
          } else if (fn == FUN_1_FLOW_1_TANK) {
            drawTower(percentBucketColor(tankPercentFull(digitalStablesData.tank2PressurePsi, digitalStablesData.tank2HeightMeters)), true);
          } else if (fn == FUN_2_TANK) {
            drawTower(percentBucketColor(tankPercentFull(digitalStablesData.tank2PressurePsi, digitalStablesData.tank2HeightMeters)), true);
          } else if (fn == DAFFODIL_WATER_TROUGH_TANK1) {
            // slot2 here is the trough (UART ultrasonic on pin 33).
            CRGB c;
            if (digitalStablesData.measuredHeight >= (digitalStablesData.maximumScepticHeight - digitalStablesData.troughlevelminimumcm)) {
              c = CRGB(255, 0, 0);
            } else if (digitalStablesData.measuredHeight >= (digitalStablesData.maximumScepticHeight - digitalStablesData.troughlevelmaximumcm)) {
              c = CRGB(0, 255, 0);
            } else {
              c = CRGB(0, 0, 255);
            }
            drawTower(c, true);
          }
          leds[14] = CRGB(0, 0, 255);
        }
      }

      FastLED.show();
    } else if (displayStatus == SHOW_INTERNET_STATUS) {
      wifistatus = wifiManager.getWifiStatus();
      if (debug) Serial.print("line 1112 inside of showintenrnetstatus wifiStatus=");
      if (debug) Serial.println(digitalStablesData.wifiStatus);
      if (debug) Serial.print("wifiManager.getAPStatus()=");
      if (debug) Serial.println(wifiManager.getAPStatus());
      if (debug) Serial.print("wifiManager.getWifiStatus()=");
      if (debug) Serial.println(wifistatus);
      if (debug) Serial.print("dsupload timer counter= ");
      if (debug) Serial.println(dscount);



      for (int i = 0; i < NUM_LEDS; i++) {
        leds[i] = CRGB(0, 0, 0);
      }

      boolean displayWifi = false;
      // Solar off: show the WiFi branch only when WiFi is actually running. Before v70 it was always
      // on with solar off, so this was "true"; since the battery gate it can be off, and the station
      // branch below then pinged through a never-started network stack (lwIP assert, v70/v71 crash
      // on HorseTrough 2026-11-06). With displayWifi false the screen shows WiFi as off (all red).
      if (!usingSolarPower) displayWifi = wifistatus;
      else {
        displayWifi = wifistatus && (hourlySolarPowerData.efficiency * 100 > digitalStablesData.minimumEfficiencyForWifi || wifiOnDemandActive());
      }
      if (displayWifi) {
        if (wifiManager.getAPStatus()) {
          leds[1] = CRGB(0, 255, 0);
          leds[2] = CRGB(0, 255, 0);
          leds[3] = CRGB(0, 255, 0);
          leds[5] = CRGB(0, 255, 0);
          leds[9] = CRGB(0, 255, 0);
          leds[11] = CRGB(0, 255, 0);
          leds[12] = CRGB(0, 255, 0);
          leds[13] = CRGB(0, 255, 0);
          FastLED.show();
        } else {
          leds[1] = CRGB(0, 0, 255);
          leds[2] = CRGB(0, 0, 255);
          leds[3] = CRGB(0, 0, 255);
          leds[5] = CRGB(0, 0, 255);
          leds[9] = CRGB(0, 0, 255);
          leds[11] = CRGB(0, 0, 255);
          leds[12] = CRGB(0, 0, 255);
          leds[13] = CRGB(0, 0, 255);
          if (digitalStablesData.wifiStatus==2) {
            leds[7] = CRGB(0, 0, 255);
          } else {
            leds[7] = CRGB(255, 0, 0);
          }
          FastLED.show();
          //
          //

          if (digitalStablesData.wifiStatus==2) {
            if (dsUploadTimer.status()) {
              // char secret[27];

              String secret = "J5KFCNCPIRCTGT2UJUZFSMQK";
              //                    leds[2] = CRGB(0, 255, 0);
              //                    FastLED.show();
              TOTP totp = TOTP(secret.c_str());
              char totpCode[7];  // get 6 char code
              long timeVal = timeManager.getTimeForCodeGeneration(currentTimerRecord);
              if (debug) Serial.print("line 1153 timeVal=");
              if (debug) Serial.println(timeVal);
              digitalStablesData.secondsTime = timeVal;
              long code = totp.gen_code(timeVal);
              if (debug) Serial.print("l;ine 1154 totp=");
              if (debug) Serial.println(code);

              wifiManager.setCurrentToTpCode(code);
              int response = wifiManager.uploadDataToDigitalStables();
              if (debug) Serial.print("l;ine 1153 uploading to ds=");
              if (debug) Serial.println(response);
              if (response == 200) {
                leds[7] = CRGB(0, 0, 255);
              } else if (response == 500) {
                leds[7] = CRGB(255, 0, 255);
              } else {
                leds[7] = CRGB(255, 0, 0);
              }
              FastLED.show();
              dsUploadTimer.reset();
            }
          } else {
            //
            // if we are here it means that there is an ipaddress
            // but internet is not available , check again if there is a reconnection
            if (initiatedWifi) wifiManager.checkInternetConnectionAvailable();  // never through an unstarted stack

            digitalStablesData.wifiStatus = wifiManager.getWifiStatus();
            if (debug) Serial.print("after rechecking digitalstable,wifiStatus=");
            if (debug) Serial.println(digitalStablesData.wifiStatus);
          }
        }
      } else {
        leds[1] = CRGB(255, 0, 0);
        leds[2] = CRGB(255, 0, 0);
        leds[3] = CRGB(255, 0, 0);
        leds[5] = CRGB(255, 0, 0);
        leds[9] = CRGB(255, 0, 0);
        leds[11] = CRGB(255, 0, 0);
        leds[12] = CRGB(255, 0, 0);
        leds[13] = CRGB(255, 0, 0);
        FastLED.show();
      }
    } else if (displayStatus == SEND_LORA_STATUS) {
      if (debug) Serial.print("showing Lora Status loraActive=");
      if (debug) Serial.print(loraActive);
      if (debug) Serial.print(" loraTxOk=");
      if (debug) Serial.println(loraTxOk);
      if (loraActive) {
        delay(random(100, 3000));
        readSensorData();
        if (debug) Serial.println("line 2708");



        digitalStablesData.asyncdata = 9;
        // if(dataManager.getDSDStoredCount()<MAXIMUM_STORED_RECORDS){
        //   dataManager.storeDSDData(digitalStablesData);
        // }

        loraLastResult = sendMessage(digitalStablesData);

        if (loraLastResult == LORA_TX_FAILED) {
          drawLora(0);
        } else if (loraLastResult == LORA_OK) {
          drawLora(1);
        }

        // A unit that stays awake never reaches goToSleep(), where vital signs are normally
        // sent - send them from here instead, every VITAL_SIGNS_AWAKE_INTERVAL_MS. (millis()
        // restarts on every wake, so a sleeping unit never gets this far.)
        if (millis() > VITAL_SIGNS_AWAKE_INTERVAL_MS && millis() - lastVitalSignsMs > VITAL_SIGNS_AWAKE_INTERVAL_MS) {
          sendVitalSigns();
        }
      } else {
        drawLora(0);
      }
    } else if (displayStatus == SHOW_ERROR_STATUS) {
      //
      // color 0=red;
      // 1=yellow
      // 2=green
      uint8_t color = 0;
      if (!foundADS) {
        if (debug) Serial.println("showing error with ADS");
        drawError(0, 0);
        showError = true;
      } else if (memoryFull) {
        if (debug) Serial.println("memory full");
        int dsdStoredCount = dataManager.getDSDStoredCount();

        if (dsdStoredCount > (int)(.7 * MAXIMUM_STORED_RECORDS)) {
          memoryFull = true;
        } else if (dsdStoredCount > (int)(.7 * MAXIMUM_STORED_RECORDS)) {
          memoryFull = true;
        }
        drawError(1, 0);
        showError = true;
      } else {
        displayStatus++;  // to make sure that this is not displayed
        showError = false;
      }
    } else if (displayStatus == SHOW_BATTERY_STATUS) {
      drawBatteryStatus(digitalStablesData.batteryVoltage, digitalStablesData.batteryCurrent);
    }
    } else {
      // CLOUDY dark cycle — LEDs off for this full display cycle
      for (int i = 0; i < NUM_LEDS; i++) leds[i] = CRGB(0, 0, 0);
      FastLED.clear(true);
      FastLED.show();
    }
    if (!holdDisplayStatus) displayStatus++;

    if (displayStatus == SHOW_ERROR_STATUS && foundADS && !memoryFull) {
      displayStatus = 0;
      if (digitalStablesData.operatingStatus == OPERATING_STATUS_CLOUDY) cloudyLedCycleOn = !cloudyLedCycleOn;
    } else if (displayStatus > 5) {
      displayStatus = 0;
      if (digitalStablesData.operatingStatus == OPERATING_STATUS_CLOUDY) cloudyLedCycleOn = !cloudyLedCycleOn;
    }

    if (!showError) {
      viewTimer.reset();
      clockTicked = false;  // discard ISR ticks accumulated during long LoRa TX/delay
    }
  }


  if (Serial.available() != 0) {
    String command = Serial.readString();
    if (command.startsWith("Ping")) {
      Serial.println(F("Ok-Ping"));
    } else if (command.startsWith("debug")) {
      int debugv = generalFunctions.getValue(command, '#', 1).toInt();
      if (debugv > 0) debug = true;
      else debug = false;
      Serial.println("Ok-debug");
      Serial.flush();
    } else if (command.startsWith("goToSleep")) {
      Serial.println("Calling deepsleep line 2584");
      goToSleep();

    } else if (command.startsWith("SetTroughParameters")) {
      // for s
      //SetTroughParameters#troughheight#troughlevelminimumcm#troughlevelmaximumcm#
      // for sumptrough
      //SetTroughParameters#29#39#45#
      //
      // for                                                                                                                                                                                                                                                                                                                                                                                                                                                                                                                                                                                                                                            tank
      //SetTroughParameters#69#42#50#

      digitalStablesData.maximumScepticHeight = generalFunctions.stringToDouble(generalFunctions.getValue(command, '#', 1));
      digitalStablesData.troughlevelminimumcm = generalFunctions.stringToDouble(generalFunctions.getValue(command, '#', 2));
      digitalStablesData.troughlevelmaximumcm = generalFunctions.stringToDouble(generalFunctions.getValue(command, '#', 3));
      Serial.println("line 2753, maximumScepticHeight=" + String(digitalStablesData.maximumScepticHeight));
      Serial.println("line 2753, troughlevelminimumcm=" + String(digitalStablesData.troughlevelminimumcm));
      Serial.println("line 2753, troughlevelmaximumcm=" + String(digitalStablesData.troughlevelmaximumcm));

      secretManager.saveTroughParameters(digitalStablesData.maximumScepticHeight, digitalStablesData.troughlevelminimumcm, digitalStablesData.troughlevelmaximumcm);


      Serial.println("Ok-SetTroughParameters");
      Serial.flush();
    } else if (command.startsWith("usingSolarPower")) {
      int usingSolarPowerv = generalFunctions.getValue(command, '#', 1).toInt();
      if (usingSolarPowerv > 0) usingSolarPower = true;
      else usingSolarPower = false;
      Serial.println("Ok-usingSolarPower");
      Serial.flush();
    } else if (command.startsWith("getUsingSolarPower")) {
      Serial.print("usingSolarPower:");
      Serial.println(usingSolarPower);
      Serial.println("Ok-usingSolarPower");
      Serial.flush();
    }

    else if (command.startsWith("storeDSDData")) {

      digitalStablesData.asyncdata = 10;
      int count = dataManager.storeDSDData(digitalStablesData);
      Serial.println(count);
      Serial.println("Ok-storeDSDData");
      Serial.flush();
    } else if (command.startsWith("SetFieldId")) {
      // fieldId= GeneralFunctions::getValue(command, '#', 1).toInt();

    } else if (command.startsWith("clearAllDSDData")) {
      dataManager.clearAllDSDData();
      Serial.println("Ok-clearAllDSDData");
      Serial.flush();

    } else if (command.startsWith("printCommaRecord")) {
      File log = LittleFS.open(COMMA_LOG_FILE, "r");
      int n = log ? (int)(log.size() / sizeof(CommaRecord)) : 0;
      if (n == 0) {
        Serial.println("No CommaRecords found");
      } else {
        Serial.println(String(n) + " records (newest last):");
        for (int i = 0; i < n; i++) {
          CommaRecord cr;
          log.readBytes((char*)&cr, sizeof(cr));
          Serial.println("[" + String(i + 1) + "] " + String(cr.devicename)
                         + "  t=" + String(cr.time)
                         + "  (" + TimeUtils::epochToString(cr.time) + ")"
                         + "  v=" + String(cr.voltage, 3) + "V");
        }
        log.close();
      }
      Serial.println("  rtc_comma_mode=" + String(rtc_comma_mode));
      Serial.println("  rtc_has_comma_data=" + String(rtc_has_comma_data));
      if (rtc_comma_mode) {
        Serial.println("  session_firstTime=" + String(rtc_comma_first_time));
        Serial.println("  session_minVoltage=" + String(rtc_comma_min_voltage, 3) + "V");
        Serial.println("  session_cycles=" + String(rtc_comma_cycle_count));
      }
      Serial.println("Ok-printCommaRecord");
      Serial.flush();

    } else if (command.startsWith("clearAllCommaRecords")) {
      clearAllCommaRecords();
      Serial.println("Ok-clearAllCommaRecords");
      Serial.flush();

    } else if (command.startsWith("printAllDSDData")) {
      dataManager.printAllDSDData();
      Serial.println("Ok-printAllDSDData");
      Serial.flush();
    } else if (command.startsWith("printCurrentDSDData")) {
      dataManager.printDigitalStablesData(digitalStablesData);
      Serial.println("--- Runtime ---");
      Serial.println("lastResetReason=" + String(resetReasonToString(lastResetReason)));
      Serial.println("rawCSWValue=" + String(rawCSWValue));
      Serial.println("cswOutput=" + String(cswOutput));
      Serial.println("usingSolarPower=" + String(usingSolarPower));

      // Operating status (human-readable)
      String osName;
      switch (digitalStablesData.operatingStatus) {
        case OPERATING_STATUS_SLEEP:    osName = "SLEEP";    break;
        case OPERATING_STATUS_NO_LED:   osName = "NO_LED";   break;
        case OPERATING_STATUS_FULL_MODE:osName = "FULL_MODE";break;
        case OPERATING_STATUS_CLOUDY:   osName = "CLOUDY";   break;
        case OPERATING_STATUS_COMMA:    osName = "COMMA";    break;
        default: osName = "UNKNOWN(" + String(digitalStablesData.operatingStatus) + ")";
      }
      Serial.println("operatingStatus=" + osName);

      // opMode bits decoded
      uint8_t om = digitalStablesData.opMode;
      Serial.println("opMode=0x" + String(om, HEX) + " (0b" + String(om, BIN) + ")");
      Serial.println("  bit0 usbJumper="    + String(om & 0x01 ? "FITTED" : "off"));
      Serial.println("  bit1 weatherFresh=" + String(om & 0x02 ? "YES" : "NO"));
      Serial.println("  bit2 INA219="       + String(om & 0x04 ? "OK"  : "MISSING"));
      Serial.println("  bit3 BH1750="       + String(om & 0x08 ? "OK"  : "MISSING"));
      Serial.println("  bit4 ADS1115="      + String(om & 0x10 ? "OK"  : "MISSING"));
      Serial.println("  bit5 RTC="          + String(om & 0x20 ? "OK"  : "MISSING"));
      Serial.println("  bit6 DS18B20="      + String(om & 0x40 ? "OK"  : "MISSING"));
      Serial.println("  bit7 SHT="          + String(om & 0x80 ? "OK"  : "MISSING"));

      // Weather forecast
      Serial.println("secondsSinceLastWeatherData=" + String(secondsSinceLastWeatherData)
                     + (secondsSinceLastWeatherData == 9999 ? " (never received)"
                       : secondsSinceLastWeatherData < 1860  ? " (fresh)"
                                                             : " (stale)"));

      // Solar
      HourlySolarPowerData _hspd = solarInfo->calculateActualPower(currentTimerRecord);
      Serial.println("solarEfficiency=" + String(_hspd.efficiency * 100, 1) + "%"
                     + "  minForLed=" + String(digitalStablesData.minimumEfficiencyForLed) + "%"
                     + "  minForWifi=" + String(digitalStablesData.minimumEfficiencyForWifi) + "%");
      Serial.println("lux=" + String(currentLux, 1)
                     + "  luxNight<" + String(luxNightThreshold));

      // Battery thresholds
      Serial.println("sleepingVoltage=" + String(sleepingVoltage)
                     + "  commaVoltage=" + String(commaVoltage) + "  commaExitV=" + String(commaExitVoltage)
                     + "  minWifiV=" + String(minimumWifiVoltage)
                     + "  minInitWifiV=" + String(minimumInitWifiVoltage)
                     + "  noSolar start/cut=" + String(minimumInitWifiVoltageNoSolar) + "/" + String(minimumWifiVoltageNoSolar));
      Serial.println("currentSecondsWithWifiVoltage=" + String(currentSecondsWithWifiVoltage)
                     + "/" + String(numberSecondsWithMinimumWifiVoltageForStartWifi));
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
