arifainchtein/Daffodil/(commit log)

2025-03-26 ff
    ff
    [Clipsal 4 Way 20mm enclosure v2.dxf, Clipsal 4 Way 20mm enclosure v2.f3z, PCB Clipsall 4 way.dxf, PCB For Clipsal 4 Way 20mm enclosure v2.stl, Pin Header 1x4 TH Pitch 2.54mm.stp, pcb.dxf]
2025-03-30 Update Daffodil.ino
    fixing secret code validation
    [Daffodil.ino]
2026-07-31 Release v11
    [ConfigSwitchPosition.csv, Creek_1_5_25.ods, SensorData.xls, TopTank.csv, battery_72h.csv, battery_72h_charging.csv, battery_yesterday_noon_5pm.csv, exportdata 22_2_25.ods]
2026-08-26 correcting dip switch values
    [Daffodil.ino]
2026-09-19 Release v42
    [partitions.csv]
2026-10-08 Remove local/working files from the repo
    [ConfigSwitchPosition.csv, Creek_1_5_25.ods, SensorData.xls, TopTank.csv, battery_72h.csv, battery_72h_charging.csv, battery_yesterday_noon_5pm.csv, exportdata 22_2_25.ods]
2026-10-08 Remove CAD files, mklittlefs and chat export from the repo
    [Clipsal 4 Way 20mm enclosure v2.dxf, PCB Clipsall 4 way.dxf, PCB For Clipsal 4 Way 20mm enclosure v2.stl, Pin Header 1x4 TH Pitch 2.54mm.stp, pcb.dxf]
2026-10-08 Remove binaries, data captures, CAD, editor files and manual sources
    [Clipsal 4 Way 20mm enclosure v2.f3z]
